kurrosetra/RCWS-mk3/Document/Wiring/Konektor Lists v.1.4.xlsx

Sheet: Connectors (1 RWS)
 | Series | Quantity | About | Manufacture
Plug | RE911-6-H-24-27-P | 1 | Slipring | Rotary Electronic
 | MS-3108-F-18-9-P | 1 | BMS | ITT
 | MS-3108-F-18-1-P | 2 | Ethernet | ITT
Receptacle | RE911-2-A-24-27-S | 1 | Slipring | Rotary Electronic
 | MS-3102-R-28-20-S | 2 | PDU & Adapter | ITT
 | MS-3102-R-24-7-S | 1 | Kokang | ITT
 | MS-3102-R-24-10-P | 1 | Baterry-PDU | ITT
 | MS-3102-R-20-27-S | 3 | Panel, Adapter & Kokang | ITT
 | MS-3102-R-18-9-S | 1 | BMS | ITT
 | MS-3102-R-18-1-S | 4 | Optronik dan Ethernet | ITT
 | MS-3102-R-16S-1-S | 2 | PDU & Panel | ITT
 | MS-3102-R-16-10-S | 2 | Trigger | ITT
 | MS-3102-R-14S-6-S | 3 | Programmer | ITT
Accessories | MS-25043-18D | 3 | Metal Caps (Ethernet & BMS) | ITT
 | MS-25043-14D | 3 | Metal Caps (Programmer) | ITT
 | 075-8520-000 | 2 | Sealing Gasket (PDU & Adapter) | ITT
 | 075-8519-000 | 2 | Sealing Gasket (Badu & Kokang) | ITT
 | 075-8517-000 | 3 | Sealing Gasket (Kokang, Panel, Adapter) | ITT
 | 075-8516-000 | 5 | Sealing Gasket (Optronik, Ethernet, BMS) | ITT
 | 075-8515-000 | 4 | Sealing Gasket (PDU, Panel, Trigger) | ITT
 | 075-8514-000 | 3 | Sealing Gasket (Programmer) | ITT
 | 012-0219-000 | 3 | Telescoping Bushing (Ethernet & BMS) | ITT
 |  | 52

Sheet: Cables (12 RWS)
Cables | Quantity
Cable#1st | 2 | pcs
Cable#2nd | 2 | pcs
Cable#3rd | 2 | pcs
Cable#4th | 2 | pcs
Cable#5th | - | pcs
Cable#6th | 12 | pcs
Cable#7th | 12 | pcs
Cable#8th | 12 | pcs
Cable#9th | 6 | pcs
