kurrosetra/RCWS-mk3/Document/fdcan_ID.xlsx

Sheet: FD-CAN params
device characteristics
FREQUENCY (kHz) | TOLERANCE (ppm) | NODE DELAY (ns) | PRESCALER | PRESCALER
 |  |  | NOMINAL | DATA
85 000 | 5 000 | 200 | 1 | 1 | Delete
Nominal bit calculations at base frequency
T q (ns) | Tprop_seg (ns) | Tbus_time (ns) | approx. cable length (m) | Prescaler: | Bit time: (Tq) | Tsync_seg (Tq) | Tprop_seg (Tq) | Tphase_seg1 (Tq) | Tphase_seg2 (Tq) | sjw (Tq) | sample point % | 2*df 1 (min) (ppm) | 2*df 2 (min) (ppm)
11.76470588 | 1470.588235 | 535.2941176 | 107.0588235 | 1 | 170 | 1 | 125 | 22 | 22 | 22 | - | 12941 | 10055
 |  |  |  |  |  |  |  |  |  |  | 87.06 +
Data bit calculations at base frequency
T q (ns) | Prescaler: | Bit time: (Tq) | Tsync_seg (Tq) | Tprop_seg (Tq) | Tphase_seg1 (Tq) | Tphase_seg2 (Tq) | sjw (Tq) | sample point: % | 2*df 3 (min) (ppm) | 2*df 4 (min) (ppm) | 2*df 5 (min) (ppm)
11.76470588 | 1 | 17 | 1 | 0 | 8 | 8 | 8 | - | 47059 | 17134 | 20305
 |  |  |  |  |  |  |  | 52.94 +
Individual Bus Timing Parameters
 | Nominal (500 000 bit/s) |  |  |  |  | Data (5 000 000 bit/s) |  |  |  |  | Tolerance (ppm)
FREQUENCY (kHz) | Tseg1 | Tseg2 | SJW | SP | PRESCALER | Tseg1 | Tseg2 | SJW | SP | PRESCALER | SYSTEM | df1 | df2 | df3 | df4 | df5
85 000 | 125 + 22 = 147 | 22 | 22 | 87.06% | 1 | 8 | 8 | 8 | 52.94% | 1 | 10 000 | 12941 | 10055 | 47059 | 17134 | 20305

Sheet: RWS-MK3
ID (Bit) |  |  |  |  |  |  |  |  |  |  | DLC | DATA (BYTE)
10 | 9 | 8 | 7 | 6 | 5 | 4 | 3 | 2 | 1 | 0 |  | 0 | 1 | 2 | 3 | 4 | 5 | 6 | 7 | 8 | 9 | 10 | 11 | 12 | 13 | 14 | 15 | 16 | 17 | 18 | 19 | 20 | 21 | 22 | 23 | 24 | 25 | 26 | 27 | 28 | 29 | 30 | 31 | 32 | 33 | 34 | 35 | 36 | 37 | 38 | 39 | 40 | 41 | 42 | 43 | 44 | 45 | 46 | 47
011 (RWS) |  |  | 0000: Motor |  |  |  | 0000: Motor & Weapon Status |  |  |  | C | Motor Status | Weapon Status |  |  | Motor Actual Value
 |  |  |  |  |  |  |  |  |  |  |  | bit0: PAN enable | bit0: Trigger Enable | Munition Counter (MSB first) |  | Actual Pan Position Value ( float in ⁰) |  |  |  | Actual Tilt Position Value (float in ⁰) |  |  |  | Actual Pan Speed Value ( float in ⁰/s) |  |  |  | Actual Tilt Speed Value ( float in ⁰/s) |  |  |  | Actual Pan voltage (V) |  | Actual Pan Current (0.1A) |  | Actual Tilt voltage (V) |  | Actual Tilt Current (0.1A) |  | RESV
 |  |  |  |  |  |  |  |  |  |  |  | bit1: TILT enable | bit1: Kokang Moving
 |  |  |  |  |  |  |  |  |  |  |  | bit2: Pan Zero Reached
 |  |  |  |  |  |  |  |  |  |  |  | bit3: Tilt Upward Reached
 |  |  |  |  |  |  |  |  |  |  |  | bit4: Tilt Downward Reached
 |  |  |  |  |  |  |  |  |  |  |  | bit5: PAN fault
 |  |  |  |  |  |  |  |  |  |  |  | bit6: TILT fault
 |  |  |  |  |  |  |  |  |  |  |  | bit7: resv
 |  |  |  |  |  |  | RESV |  |  |  | 0
 |  |  | 0001: PANEL |  |  |  | 0000: Panel & Button Command |  |  |  | B | Movement mode: | camera command: | Weapon command: | LRF & IMU command: | Motor Command
 |  |  |  |  |  |  |  |  |  |  |  | bit0: PAN enable | bit0: | bit0: Trigger Enable | bit0: LRF ENABLE | PAN Speed Desired (in ⁰/s) |  |  |  | TILT Speed Desired (in ⁰/s) |  |  |  | PAN Speed Correction (in ⁰/s) |  |  |  | TILT Speed Correction (in ⁰/s)
 |  |  |  |  |  |  |  |  |  |  |  | bit1: TILT enable | 0: day camera | bit1: Cock Start | bit1: LRF START
 |  |  |  |  |  |  |  |  |  |  |  | bit2: Stabilize Mode | 1: thermal camera | bit2: Munition Counter Reset | bit2: Continous mode
 |  |  |  |  |  |  |  |  |  |  |  | bit3: Track Mode | bit[2..1]: |  | bit3: LRF POINTER ON/OFF
 |  |  |  |  |  |  |  |  |  |  |  |  | 00: no zoom |  | bit4: IMU fast rate
 |  |  |  |  |  |  |  |  |  |  |  |  | 01: zoom in
 |  |  |  |  |  |  |  |  |  |  |  |  | 10: zoom out
 |  |  |  |  |  |  |  |  |  |  |  |  | bit[4..3]:
 |  |  |  |  |  |  |  |  |  |  |  |  | 00: no focus
 |  |  |  |  |  |  |  |  |  |  |  |  | 01: focus far
 |  |  |  |  |  |  |  |  |  |  |  |  | 10: focus near
 |  |  |  |  |  |  |  |  |  |  |  |  | bit[6..5]:
 |  |  |  |  |  |  |  |  |  |  |  |  | 00: none
 |  |  |  |  |  |  |  |  |  |  |  |  | 01: resv up
 |  |  |  |  |  |  |  |  |  |  |  |  | 10: resv down
 |  |  |  |  |  |  |  |  |  |  |  |  | bit7:
 |  |  |  |  |  |  |  |  |  |  |  |  | 0:stabilizer OFF
 |  |  |  |  |  |  |  |  |  |  |  |  | 1: stabilizer ON
 |  |  |  |  |  |  | RESV |  |  |  | 0
 |  |  | 0010: Optronik |  |  |  | 0000: Optronik Status |  |  |  | 8 | camera state: | LRF Value:
 |  |  |  |  |  |  |  |  |  |  |  | bit0: camera selection | Counter | Distance 1 (MSB first) |  | Distance 2 (MSB first) |  | Distance 3 (MSB first)
 |  |  |  |  |  |  |  |  |  |  |  | 0: SONY Active
 |  |  |  |  |  |  |  |  |  |  |  | 1: Thermal Active
 |  |  |  |  |  |  |  |  |  |  |  | bit[1..3]: zoom value
 |  |  |  |  |  |  | RESV
 |  |  | 0011: IMU |  |  |  | 0000: IMU Value |  |  |  | 9 | YAW |  |  |  | PITCH |  |  |  | ROLL
 |  |  |  |  |  |  |  |  |  |  |  | -180.000f s/d 180.000f |  |  |  | -90.000f s/d 90.000f |  |  |  | -90.000f s/d 90.000f
 |  |  |  |  |  |  | RESV |  |  |  | 0

Sheet: Update Rate
ID |  |  | Name | Update Rate (ms) | BUS LOAD (500kbps) | BUS LOAD (250kbps)
3 | 0 | 0 | Motor & Weapon Status | 50 | 2620 | 2620
 | 1 | 0 | Panel & Button Command | 50 | 2620 | 2620
 | 2 | 0 | Optronik Status | 100 | 1310 | 1310
 | 3 | 0 | IMU Value | 50 | 2620 | 2620
 |  |  |  | %= | 1.834 | 3.668

Sheet: PC
SEND to PC:
0 | 1 | 2 | 3 | 4 | 5 | 6
state | lrf value (m) |  | rws's az angle (deg) |  | rws's el angle (1/100 deg)
bit[0]: camera active (0: day camera, 1: thermal)
bit[1..2]: zoom level (0: observe view, 1: combat view, 2: tele view)
bit[3..4]: tracker target select (0: select stop, 1: next, 2: prev)
bit[5..6]: tracker gate resize (0: resize stop, 1: bigger, 2: smaller)
RECV from PC:
0 | 1 | 2 | 3 | 4 | 5 | 6 | 7 | 8 | 9 | 10 | 11
state | balistik offset (px)
bit[0]: weapon type (0: 7.62mm, 1: 12.7mm)
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
