kurrosetra/RCWS-mk3/Document/Wiring/Konektor Lists v.1.2a.xlsx

 | Series | Quantity | About
Plug | RE911-6-H-24-27-P | 1 | Slipring
 | MS-3108-F-18-9-P | 1 | BMS
 | MS-3108-F-18-1-P | 2 | Ethernet
 | MS-3106-F-14S-6-P | 1 | Programmer
Receptacle | RE911-2-A-24-27-S | 1 | Slipring
 | MS-3102-R-28-20-S | 2 | PDU & Adapter
 | MS-3102-R-24-7-S | 1 | Kokang
 | MS-3102-R-24-10-P | 1 | Baterry-PDU
 | MS-3102-R-20-27-S | 3 | Panel, Adapter & Kokang
 | MS-3102-R-18-9-S | 1 | BMS
 | MS-3102-R-18-1-S | 4 | Optronik dan Ethernet
 | MS-3102-R-16S-1-S | 2 | PDU & Panel
 | MS-3102-R-16-10-S | 2 | Trigger
 | MS-3102-R-14S-6-S | 3 | Programmer
Accessories | MS-25043-18D | 3 | Metal Caps (Ethernet & BMS)
 | MS-25043-14D | 3 | Metal Caps (Programmer)
 | 075-8520-000 | 2 | Sealing Gasket (PDU & Adapter)
 | 075-8519-000 | 2 | Sealing Gasket (Badu & Kokang)
 | 075-8517-000 | 3 | Sealing Gasket (Kokang, Panel, Adapter)
 | 075-8516-000 | 5 | Sealing Gasket (Optronik, Ethernet, BMS)
 | 075-8515-000 | 4 | Sealing Gasket (PDU, Panel, Trigger)
 | 075-8514-000 | 3 | Sealing Gasket (Programmer)
 | 012-8554-000 | 1 | Telescoping Bushing (Programmer)
 | 012-0219-000 | 3 | Telescoping Bushing (Ethernet & BMS)
 |  | 54
