kurrosetra/RCWS-mk3/Panel/Board/Panel.brd

## EAGLE design Panel/Board/Panel.brd (2022-07-08)

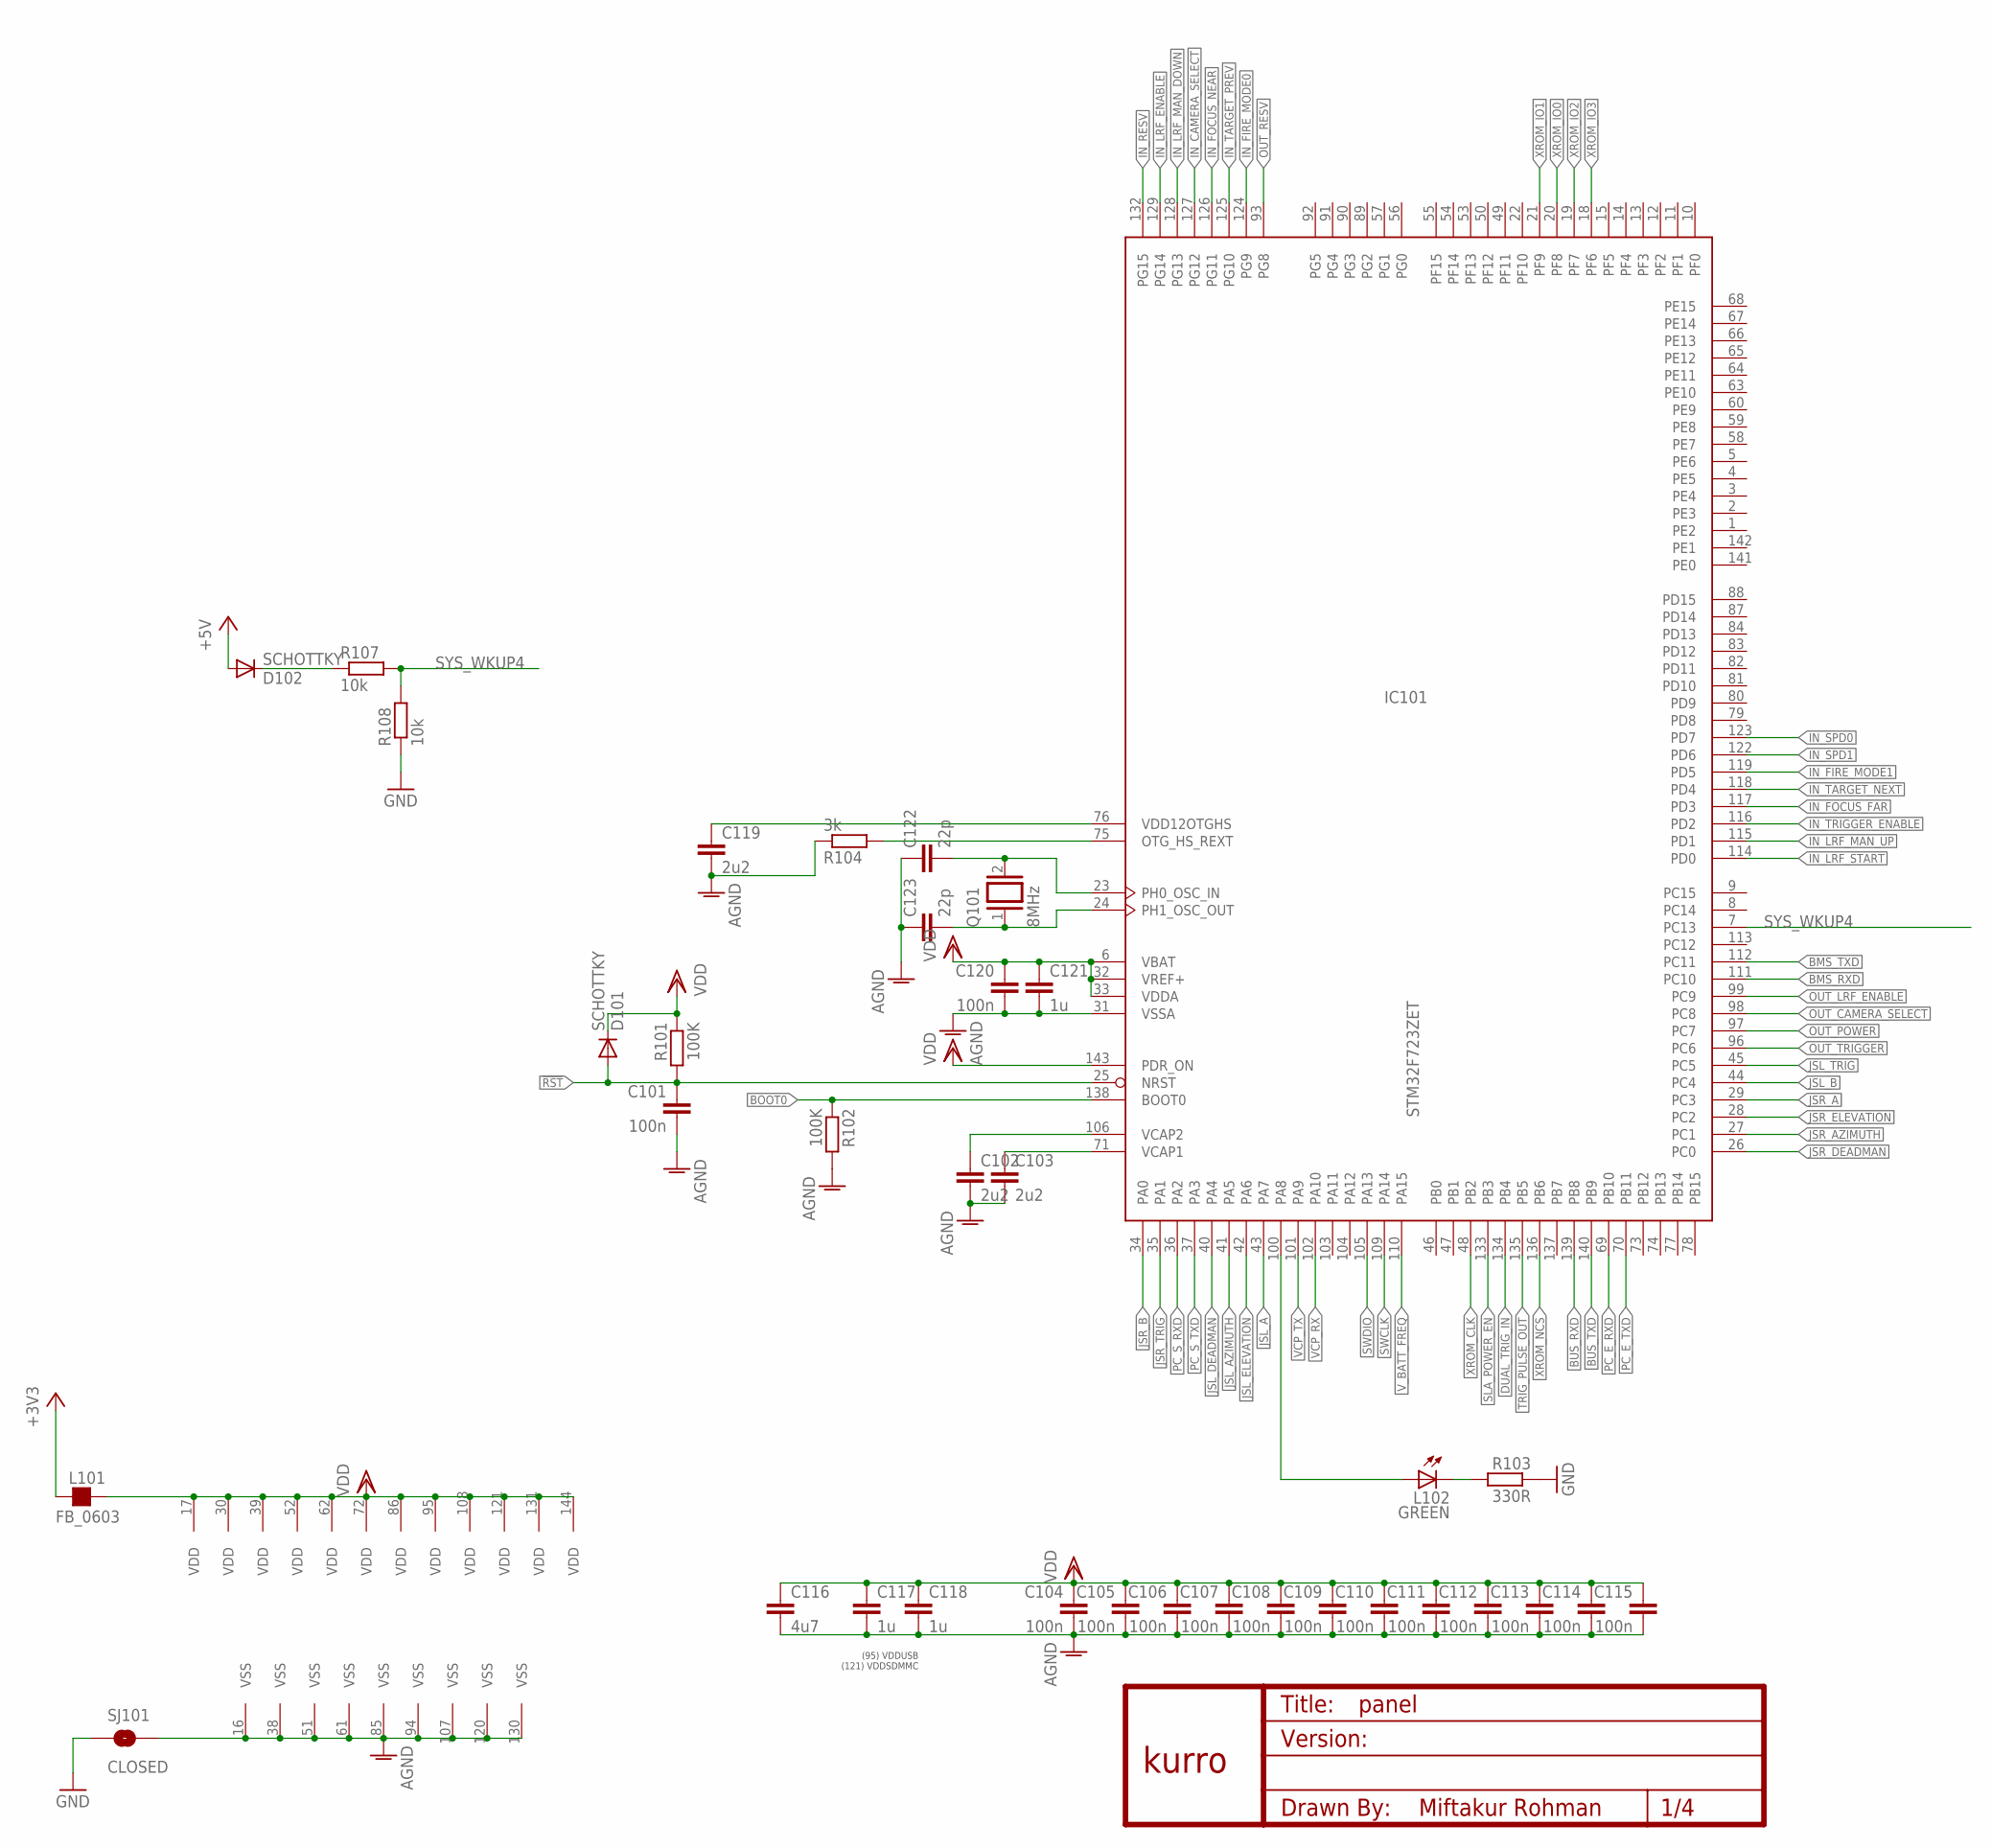
[picture p1: schematic Panel.sch, sheet 1, MAIN]

Parts:
C101, C104, C105, C106, C107, C108, C109, C110, C111, C112, C113, C114, C115, C120: 100n; C0603
C102, C103, C119: 2u2; C0805
C116: 4u7; C0805
C117, C118, C121: 1u; C0805
C122, C123: 22p; C0603
D101, D102: SCHOTTKY; MICROMELF-W
IC101: STM32F723ZET; LQFP144-2
L101: FB_0603; L0603
L102: GREEN; CHIP-LED0805
Q101: 8MHz; QS
R101, R102: 100K; R0603
R103: 330R; R0603
R104: 3k; R0603
R107, R108: 10k; R0603
SJ101: CLOSED; SJ_2S-TRACE_THICK
U$2: KURRO_FOOTPRINT; KURRO-LOGO

Connections:
!RST: C101.1, D101.A, IC101.25 (NRST), R101.2; also elsewhere on the board
+3V3: L101.1; also elsewhere on the board
+5V: D102.A; also elsewhere on the board
AGND: C101.2, C102.2, C103.2, C104.2, C105.2, C106.2, C107.2, C108.2, C109.2, C110.2, C111.2, C112.2, C113.2, C114.2, C115.2, C116.2, C117.2, C118.2, C119.2, C120.2, C121.2, C122.1, C123.1, IC101.16 (VSS), IC101.31 (VSSA), IC101.38 (VSS), IC101.51 (VSS), IC101.61 (VSS), IC101.85 (VSS), IC101.94 (VSS), IC101.107 (VSS), IC101.120 (VSS), IC101.130 (VSS), R102.2, R104.1, SJ101.2
BMS_RXD: IC101.111 (PC10); also elsewhere on the board
BMS_TXD: IC101.112 (PC11); also elsewhere on the board
BOOT0: IC101.138 (BOOT0), R102.1; also elsewhere on the board
BUS_RXD: IC101.139 (PB8); also elsewhere on the board
BUS_TXD: IC101.140 (PB9); also elsewhere on the board
DUAL_TRIG_IN: IC101.134 (PB4); also elsewhere on the board
GND: R103.1, R108.1, SJ101.1; also elsewhere on the board
IN_CAMERA_SELECT: IC101.127 (PG12); also elsewhere on the board
IN_FIRE_MODE0: IC101.124 (PG9); also elsewhere on the board
IN_FIRE_MODE1: IC101.119 (PD5); also elsewhere on the board
IN_FOCUS_FAR: IC101.117 (PD3); also elsewhere on the board
IN_FOCUS_NEAR: IC101.126 (PG11); also elsewhere on the board
IN_LRF_ENABLE: IC101.129 (PG14); also elsewhere on the board
IN_LRF_MAN_DOWN: IC101.128 (PG13); also elsewhere on the board
IN_LRF_MAN_UP: IC101.115 (PD1); also elsewhere on the board
IN_LRF_START: IC101.114 (PD0); also elsewhere on the board
IN_RESV: IC101.132 (PG15); also elsewhere on the board
IN_SPD0: IC101.123 (PD7); also elsewhere on the board
IN_SPD1: IC101.122 (PD6); also elsewhere on the board
IN_TARGET_NEXT: IC101.118 (PD4); also elsewhere on the board
IN_TARGET_PREV: IC101.125 (PG10); also elsewhere on the board
IN_TRIGGER_ENABLE: IC101.116 (PD2); also elsewhere on the board
JSL_A: IC101.43 (PA7); also elsewhere on the board
JSL_AZIMUTH: IC101.41 (PA5); also elsewhere on the board
JSL_B: IC101.44 (PC4); also elsewhere on the board
JSL_DEADMAN: IC101.40 (PA4); also elsewhere on the board
JSL_ELEVATION: IC101.42 (PA6); also elsewhere on the board
JSL_TRIG: IC101.45 (PC5); also elsewhere on the board
JSR_A: IC101.29 (PC3); also elsewhere on the board
JSR_AZIMUTH: IC101.27 (PC1); also elsewhere on the board
JSR_B: IC101.34 (PA0); also elsewhere on the board
JSR_DEADMAN: IC101.26 (PC0); also elsewhere on the board
JSR_ELEVATION: IC101.28 (PC2); also elsewhere on the board
JSR_TRIG: IC101.35 (PA1); also elsewhere on the board
unnamed: IC101.75 (OTG_HS_REXT), R104.2
unnamed: L102.C, R103.2
unnamed: IC101.100 (PA8), L102.A
unnamed: C119.1, IC101.76 (VDD12OTGHS)
unnamed: C123.2, IC101.24 (PH1_OSC_OUT), Q101.1
unnamed: C122.2, IC101.23 (PH0_OSC_IN), Q101.2
unnamed: D102.C, R107.1
OUT_CAMERA_SELECT: IC101.98 (PC8); also elsewhere on the board
OUT_LRF_ENABLE: IC101.99 (PC9); also elsewhere on the board
OUT_POWER: IC101.97 (PC7); also elsewhere on the board
OUT_RESV: IC101.93 (PG8); also elsewhere on the board
OUT_TRIGGER: IC101.96 (PC6); also elsewhere on the board
PC_E_RXD: IC101.69 (PB10); also elsewhere on the board
PC_E_TXD: IC101.70 (PB11); also elsewhere on the board
PC_S_RXD: IC101.36 (PA2); also elsewhere on the board
PC_S_TXD: IC101.37 (PA3); also elsewhere on the board
SLA_POWER_EN: IC101.133 (PB3); also elsewhere on the board
SWCLK: IC101.109 (PA14); also elsewhere on the board
SWDIO: IC101.105 (PA13); also elsewhere on the board
SYS_WKUP4: IC101.7 (PC13), R107.2, R108.2
TRIG_PULSE_OUT: IC101.135 (PB5); also elsewhere on the board
VCAP1: C103.1, IC101.71 (VCAP1)
VCAP2: C102.1, IC101.106 (VCAP2)
VCP_RX: IC101.102 (PA10); also elsewhere on the board
VCP_TX: IC101.101 (PA9); also elsewhere on the board
VDD: C104.1, C105.1, C106.1, C107.1, C108.1, C109.1, C110.1, C111.1, C112.1, C113.1, C114.1, C115.1, C116.1, C117.1, C118.1, C120.1, C121.1, D101.C, IC101.6 (VBAT), IC101.17 (VDD), IC101.30 (VDD), IC101.32 (VREF+), IC101.33 (VDDA), IC101.39 (VDD), IC101.52 (VDD), IC101.62 (VDD), IC101.72 (VDD), IC101.86 (VDD), IC101.95 (VDD), IC101.108 (VDD), IC101.121 (VDD), IC101.131 (VDD), IC101.143 (PDR_ON), IC101.144 (VDD), L101.2, R101.1; also elsewhere on the board
V_BATT_FREQ: IC101.110 (PA15); also elsewhere on the board
XROM_CLK: IC101.48 (PB2); also elsewhere on the board
XROM_IO0: IC101.20 (PF8); also elsewhere on the board
XROM_IO1: IC101.21 (PF9); also elsewhere on the board
XROM_IO2: IC101.19 (PF7); also elsewhere on the board
XROM_IO3: IC101.18 (PF6); also elsewhere on the board
XROM_NCS: IC101.136 (PB6); also elsewhere on the board

Notes on the sheet:
(95) VDDUSB (121) VDDSDMMC

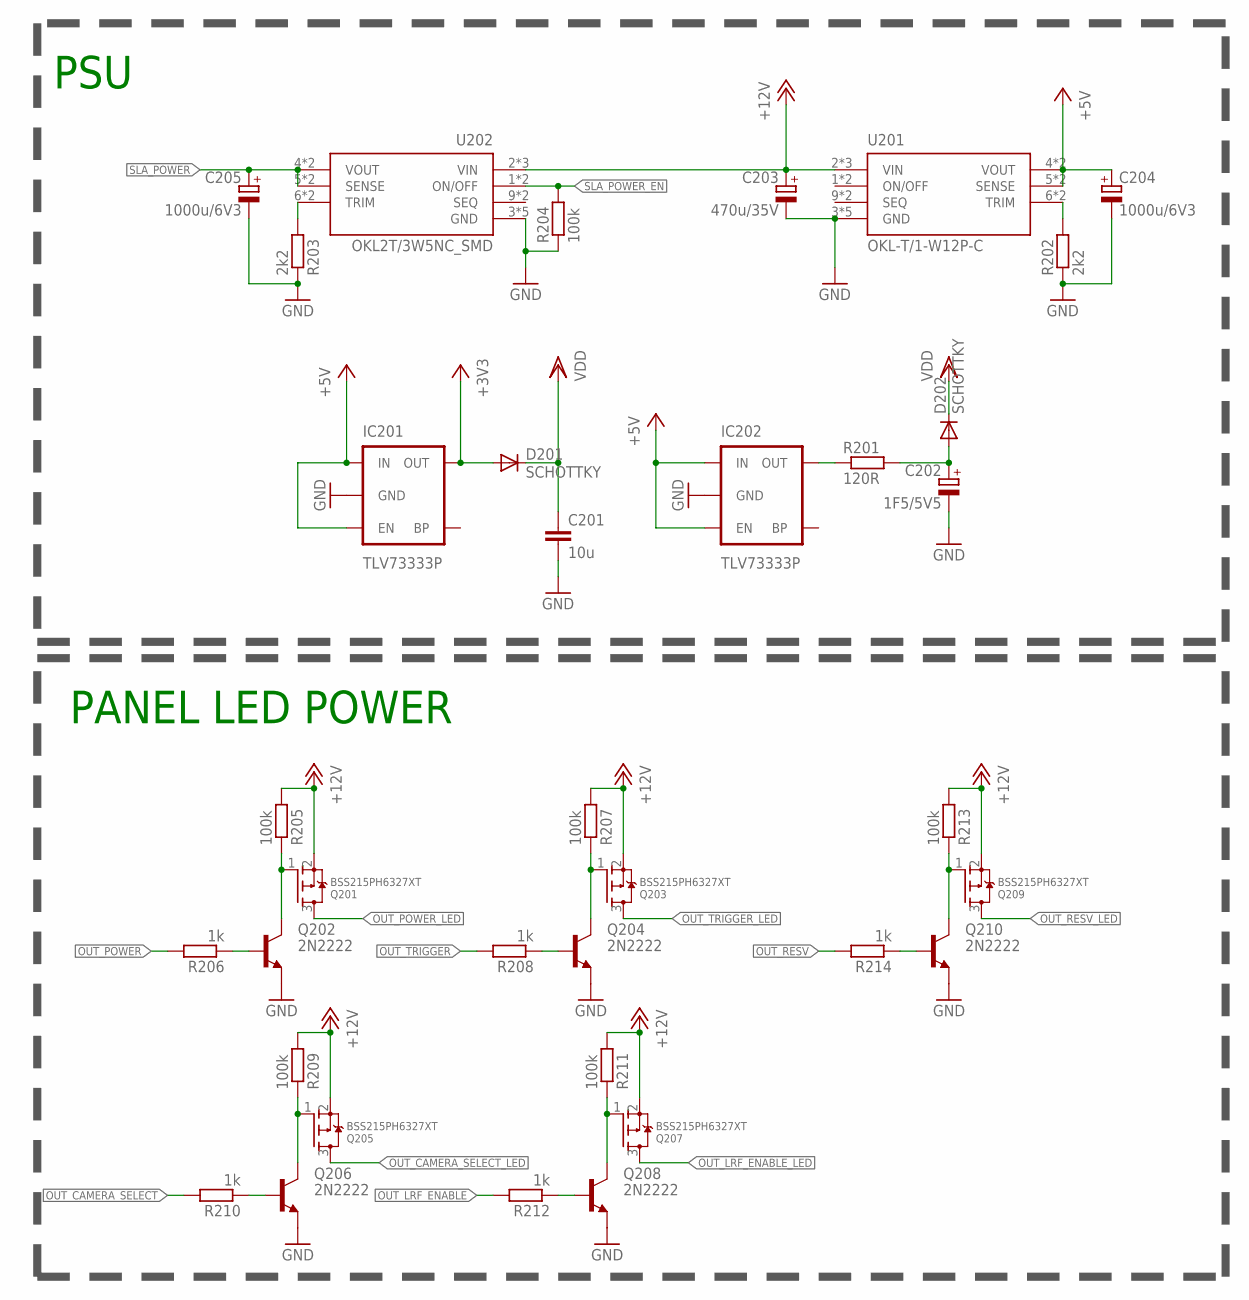
[picture p2: schematic Panel.sch, sheet 2, PSU]

Parts:
C201: 10u; C0805
C202: 1F5/5V5; SC_1F/5V5
C203: 470u/35V; 153CLV-1012
C204, C205: 1000u/6V3; 153CLV-0810
D201, D202: SCHOTTKY; MICROMELF-W
IC201, IC202: TLV73333P; SOT23-5
Q201, Q203, Q205, Q207, Q209: BSS215PH6327XT; SOT23-W
Q202, Q204, Q206, Q208, Q210: 2N2222; SOT23
R201: 120R; R0603
R202, R203: 2k2; R0603
R204, R205, R207, R209, R211, R213: 100k; R0603
R206, R208, R210, R212, R214: 1k; R0603
U201: OKL-T/1-W12P-C; OKL2T/3W5NC
U202: OKL2T/3W5NC_SMD; OKL2T/3W5NC

Connections:
+3V3: D201.A, IC201.5 (OUT); also elsewhere on the board
+5V: C204.+, IC201.1 (IN), IC201.3 (EN), IC202.1 (IN), IC202.3 (EN), U201.4 (VOUT), U201.4@1 (VOUT), U201.5 (SENSE), U201.5@1 (SENSE); also elsewhere on the board
+12V: C203.+, Q201.2 (S), Q203.2 (S), Q205.2 (S), Q207.2 (S), Q209.2 (S), R205.2, R207.2, R209.2, R211.2, R213.2, U201.2 (VIN), U201.2@1 (VIN), U201.2@2 (VIN), U202.2 (VIN), U202.2@1 (VIN), U202.2@2 (VIN); also elsewhere on the board
GND: C201.2, C202.2 (-), C203.-, C204.-, C205.-, IC201.2 (GND), IC202.2 (GND), Q202.2 (E), Q204.2 (E), Q206.2 (E), Q208.2 (E), Q210.2 (E), R202.1, R203.1, R204.1, U201.3 (GND), U201.3@1 (GND), U201.3@2 (GND), U201.7 (GND), U201.7@1 (GND), U202.3 (GND), U202.3@1 (GND), U202.3@2 (GND), U202.7 (GND), U202.7@1 (GND); also elsewhere on the board
unnamed: R202.2, U201.6 (TRIM), U201.6@1 (TRIM)
unnamed: IC202.5 (OUT), R201.1
unnamed: Q209.1 (G), Q210.3 (C), R213.1
unnamed: Q201.1 (G), Q202.3 (C), R205.1
unnamed: Q202.1 (B), R206.1
unnamed: Q203.1 (G), Q204.3 (C), R207.1
unnamed: Q204.1 (B), R208.1
unnamed: Q210.1 (B), R214.1
unnamed: Q205.1 (G), Q206.3 (C), R209.1
unnamed: Q206.1 (B), R210.1
unnamed: Q207.1 (G), Q208.3 (C), R211.1
unnamed: Q208.1 (B), R212.1
unnamed: R203.2, U202.6 (TRIM), U202.6@1 (TRIM)
OUT_CAMERA_SELECT: R210.2; also elsewhere on the board
OUT_CAMERA_SELECT_LED: Q205.3 (D); also elsewhere on the board
OUT_LRF_ENABLE: R212.2; also elsewhere on the board
OUT_LRF_ENABLE_LED: Q207.3 (D); also elsewhere on the board
OUT_POWER: R206.2; also elsewhere on the board
OUT_POWER_LED: Q201.3 (D); also elsewhere on the board
OUT_RESV: R214.2; also elsewhere on the board
OUT_RESV_LED: Q209.3 (D); also elsewhere on the board
OUT_TRIGGER: R208.2; also elsewhere on the board
OUT_TRIGGER_LED: Q203.3 (D); also elsewhere on the board
SLA_POWER: C205.+, U202.4 (VOUT), U202.4@1 (VOUT), U202.5 (SENSE), U202.5@1 (SENSE); also elsewhere on the board
SLA_POWER_EN: R204.2, U202.1 (ON/OFF), U202.1@1 (ON/OFF); also elsewhere on the board
VDD: C201.1, D201.C, D202.C; also elsewhere on the board
V_SCAP1: C202.1 (+), D202.A, R201.2

Notes on the sheet:
PSU
PANEL LED POWER

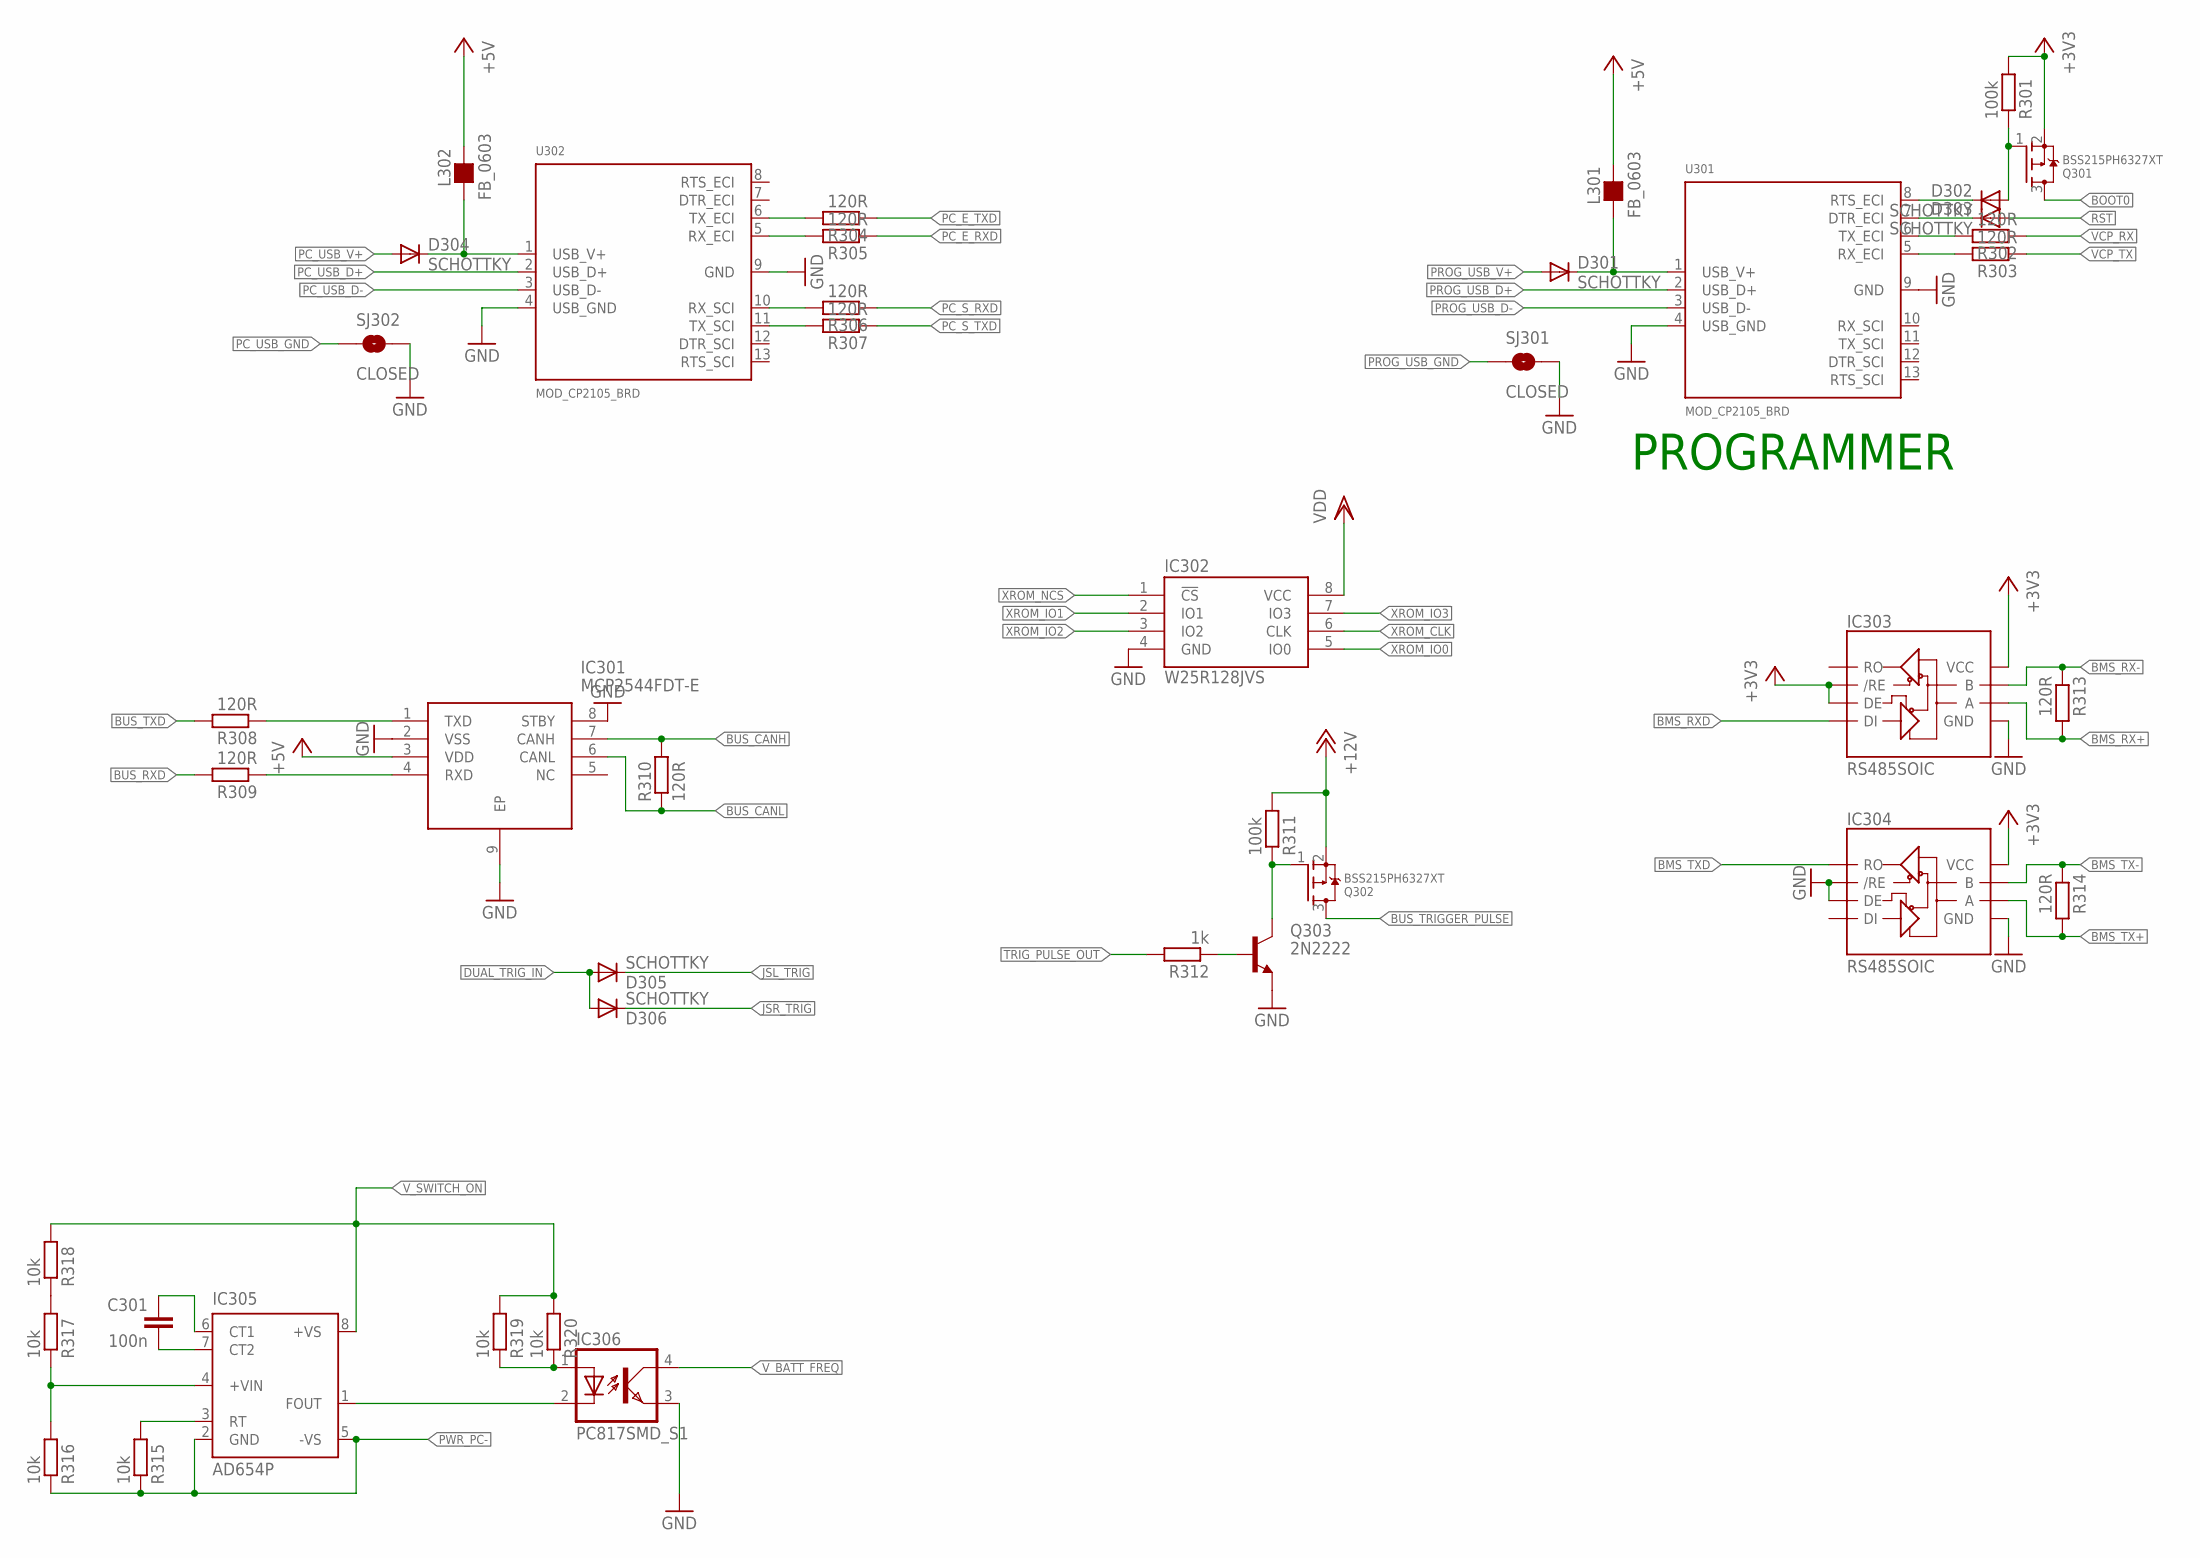
[picture p3: schematic Panel.sch, sheet 3, I/F]

Parts:
C301: 100n; C0603
D301, D302, D303, D304, D305, D306: SCHOTTKY; MICROMELF-W
IC301: MCP2544FDT-E; TDFN-8
IC302: W25R128JVS; SO08
IC303, IC304: RS485SOIC; SO08
IC305: AD654P; DIL08
IC306: PC817SMD_S1; PC817SMD
L301, L302: FB_0603; L0603
Q301, Q302: BSS215PH6327XT; SOT23-W
Q303: 2N2222; SOT23
R301, R311: 100k; R0603
R302, R303, R304, R305, R306, R307, R308, R309, R310, R313, R314: 120R; R0603
R312: 1k; R0603
R315, R316, R317, R318, R319, R320: 10k; R0603
SJ301, SJ302: CLOSED; SJ_2S-TRACE_THICK
U301, U302: MOD_CP2105_BRD; MOD_CP2105_BOARD

Connections:
!RST: D303.A; also elsewhere on the board
+3V3: IC303.2 (/RE), IC303.3 (DE), IC303.8 (VCC), IC304.8 (VCC), Q301.2 (S), R301.2; also elsewhere on the board
+5V: IC301.3 (VDD), L301.2, L302.2; also elsewhere on the board
+12V: Q302.2 (S), R311.2; also elsewhere on the board
BMS_RX+: IC303.6 (A), R313.2; also elsewhere on the board
BMS_RX-: IC303.7 (B), R313.1; also elsewhere on the board
BMS_RXD: IC303.4 (DI); also elsewhere on the board
BMS_TX+: IC304.6 (A), R314.2; also elsewhere on the board
BMS_TX-: IC304.7 (B), R314.1; also elsewhere on the board
BMS_TXD: IC304.1 (RO); also elsewhere on the board
BOOT0: Q301.3 (D); also elsewhere on the board
BUS_CANH: IC301.7 (CANH), R310.2; also elsewhere on the board
BUS_CANL: IC301.6 (CANL), R310.1; also elsewhere on the board
BUS_RXD: R309.2; also elsewhere on the board
BUS_TRIGGER_PULSE: Q302.3 (D); also elsewhere on the board
BUS_TXD: R308.2; also elsewhere on the board
DUAL_TRIG_IN: D305.A, D306.A; also elsewhere on the board
GND: IC301.2 (VSS), IC301.8 (STBY), IC301.9 (EP), IC302.4 (GND), IC303.5 (GND), IC304.2 (/RE), IC304.3 (DE), IC304.5 (GND), IC306.3 (EMIT), Q303.2 (E), SJ301.2, SJ302.2, U301.4 (USB_GND), U301.9 (GND), U302.4 (USB_GND), U302.9 (GND); also elsewhere on the board
JSL_TRIG: D305.C; also elsewhere on the board
JSR_TRIG: D306.C; also elsewhere on the board
unnamed: Q302.1 (G), Q303.3 (C), R311.1
unnamed: Q303.1 (B), R312.1
unnamed: IC301.1 (TXD), R308.1
unnamed: IC301.4 (RXD), R309.1
unnamed: R303.2, U301.5 (RX_ECI)
unnamed: IC305.1 (FOUT), IC306.2 (C)
unnamed: R302.2, U301.6 (TX_ECI)
unnamed: D303.C, U301.7 (DTR_ECI)
unnamed: D302.C, U301.8 (RTS_ECI)
unnamed: D301.C, L301.1, U301.1 (USB_V+)
unnamed: D302.A, Q301.1 (G), R301.1
unnamed: R305.2, U302.5 (RX_ECI)
unnamed: R304.2, U302.6 (TX_ECI)
unnamed: R306.2, U302.10 (RX_SCI)
unnamed: R307.2, U302.11 (TX_SCI)
unnamed: IC306.1 (A), R319.1, R320.1
unnamed: D304.C, L302.1, U302.1 (USB_V+)
unnamed: IC305.3 (RT), R315.2
unnamed: C301.2, IC305.7 (CT2)
unnamed: C301.1, IC305.6 (CT1)
unnamed: IC305.4 (+VIN), R316.2, R317.1
unnamed: R317.2, R318.1
PC_E_RXD: R305.1; also elsewhere on the board
PC_E_TXD: R304.1; also elsewhere on the board
PC_S_RXD: R306.1; also elsewhere on the board
PC_S_TXD: R307.1; also elsewhere on the board
PC_USB_D+: U302.2 (USB_D+); also elsewhere on the board
PC_USB_D-: U302.3 (USB_D-); also elsewhere on the board
PC_USB_GND: SJ302.1; also elsewhere on the board
PC_USB_V+: D304.A; also elsewhere on the board
PROG_USB_D+: U301.2 (USB_D+); also elsewhere on the board
PROG_USB_D-: U301.3 (USB_D-); also elsewhere on the board
PROG_USB_GND: SJ301.1; also elsewhere on the board
PROG_USB_V+: D301.A; also elsewhere on the board
PWR_PC-: IC305.2 (GND), IC305.5 (-VS), R315.1, R316.1; also elsewhere on the board
TRIG_PULSE_OUT: R312.2; also elsewhere on the board
VCP_RX: R302.1; also elsewhere on the board
VCP_TX: R303.1; also elsewhere on the board
VDD: IC302.8 (VCC); also elsewhere on the board
V_BATT_FREQ: IC306.4 (COL); also elsewhere on the board
V_SWITCH_ON: IC305.8 (+VS), R318.2, R319.2, R320.2; also elsewhere on the board
XROM_CLK: IC302.6 (CLK); also elsewhere on the board
XROM_IO0: IC302.5 (IO0); also elsewhere on the board
XROM_IO1: IC302.2 (IO1); also elsewhere on the board
XROM_IO2: IC302.3 (IO2); also elsewhere on the board
XROM_IO3: IC302.7 (IO3); also elsewhere on the board
XROM_NCS: IC302.1 (!CS); also elsewhere on the board

Notes on the sheet:
PROGRAMMER

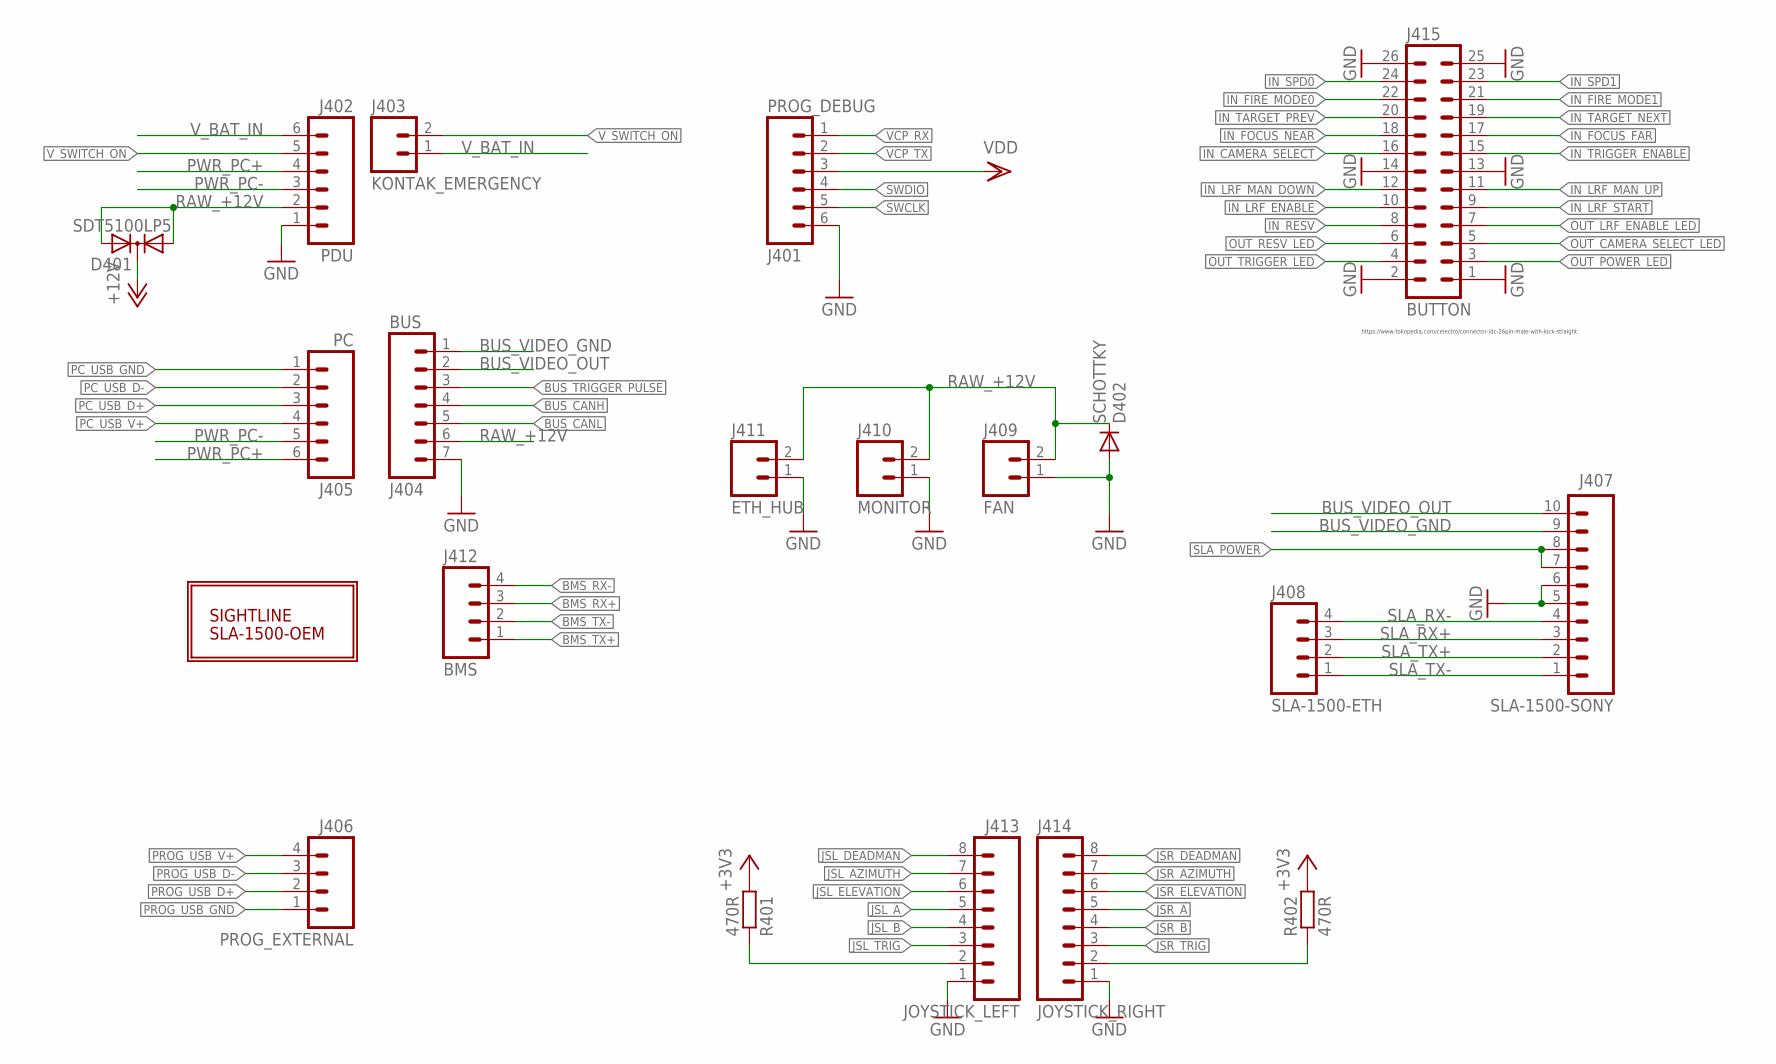
[picture p4: schematic Panel.sch, sheet 4, CONNECTOR]

Parts:
D401: SDT5100LP5; POWERDI5-3
D402: SCHOTTKY; MICROMELF-W
J401: PROG_DEBUG; XHS-6-VERT-SMD
J402: PDU; XHS-6-RA
J403: KONTAK_EMERGENCY; XHS-2-RA
J404: BUS; XHS-7-RA
J405: PC; XHS-6-RA
J406: PROG_EXTERNAL; XHS-4-RA
J407: SLA-1500-SONY; XHS-10-VERT
J408: SLA-1500-ETH; XHS-4-RA
J409: FAN; XHS-2-VERT
J410: MONITOR; XHS-2-RA
J411: ETH_HUB; XHS-2-VERT
J412: BMS; XHS-4-RA
J413: JOYSTICK_LEFT; XHS-8-RA
J414: JOYSTICK_RIGHT; XHS-8-RA
J415: BUTTON; 26V
R401, R402: 470R; R0603
U401: SLA-1500-OEM
U402: SLA-1500-OEM-RESTRICT; SLA_1500-OEM-RESTRICT

Connections:
+3V3: R401.2, R402.2; also elsewhere on the board
+12V: D401.3; also elsewhere on the board
BMS_RX+: J412.3; also elsewhere on the board
BMS_RX-: J412.4; also elsewhere on the board
BMS_TX+: J412.1; also elsewhere on the board
BMS_TX-: J412.2; also elsewhere on the board
BUS_CANH: J404.4; also elsewhere on the board
BUS_CANL: J404.5; also elsewhere on the board
BUS_TRIGGER_PULSE: J404.3; also elsewhere on the board
BUS_VIDEO_GND: J404.1, J407.9
BUS_VIDEO_OUT: J404.2, J407.10
GND: D402.A, J401.6, J402.1, J404.7, J407.5, J407.6, J409.1, J410.1, J411.1, J413.1, J414.1, J415.1, J415.2, J415.13, J415.14, J415.25, J415.26; also elsewhere on the board
IN_CAMERA_SELECT: J415.16; also elsewhere on the board
IN_FIRE_MODE0: J415.22; also elsewhere on the board
IN_FIRE_MODE1: J415.21; also elsewhere on the board
IN_FOCUS_FAR: J415.17; also elsewhere on the board
IN_FOCUS_NEAR: J415.18; also elsewhere on the board
IN_LRF_ENABLE: J415.10; also elsewhere on the board
IN_LRF_MAN_DOWN: J415.12; also elsewhere on the board
IN_LRF_MAN_UP: J415.11; also elsewhere on the board
IN_LRF_START: J415.9; also elsewhere on the board
IN_RESV: J415.8; also elsewhere on the board
IN_SPD0: J415.24; also elsewhere on the board
IN_SPD1: J415.23; also elsewhere on the board
IN_TARGET_NEXT: J415.19; also elsewhere on the board
IN_TARGET_PREV: J415.20; also elsewhere on the board
IN_TRIGGER_ENABLE: J415.15; also elsewhere on the board
JSL_A: J413.5; also elsewhere on the board
JSL_AZIMUTH: J413.7; also elsewhere on the board
JSL_B: J413.4; also elsewhere on the board
JSL_DEADMAN: J413.8; also elsewhere on the board
JSL_ELEVATION: J413.6; also elsewhere on the board
JSL_TRIG: J413.3; also elsewhere on the board
JSR_A: J414.5; also elsewhere on the board
JSR_AZIMUTH: J414.7; also elsewhere on the board
JSR_B: J414.4; also elsewhere on the board
JSR_DEADMAN: J414.8; also elsewhere on the board
JSR_ELEVATION: J414.6; also elsewhere on the board
JSR_TRIG: J414.3; also elsewhere on the board
unnamed: J414.2, R402.1
unnamed: J413.2, R401.1
OUT_CAMERA_SELECT_LED: J415.5; also elsewhere on the board
OUT_LRF_ENABLE_LED: J415.7; also elsewhere on the board
OUT_POWER_LED: J415.3; also elsewhere on the board
OUT_RESV_LED: J415.6; also elsewhere on the board
OUT_TRIGGER_LED: J415.4; also elsewhere on the board
PC_USB_D+: J405.3; also elsewhere on the board
PC_USB_D-: J405.2; also elsewhere on the board
PC_USB_GND: J405.1; also elsewhere on the board
PC_USB_V+: J405.4; also elsewhere on the board
PROG_USB_D+: J406.2; also elsewhere on the board
PROG_USB_D-: J406.3; also elsewhere on the board
PROG_USB_GND: J406.1; also elsewhere on the board
PROG_USB_V+: J406.4; also elsewhere on the board
PWR_PC+: J402.4, J405.6
PWR_PC-: J402.3, J405.5; also elsewhere on the board
RAW_+12V: D401.1, D401.2, D402.C, J402.2, J404.6, J409.2, J410.2, J411.2
SLA_POWER: J407.7, J407.8; also elsewhere on the board
SLA_RX+: J407.3, J408.3
SLA_RX-: J407.4, J408.4
SLA_TX+: J407.2, J408.2
SLA_TX-: J407.1, J408.1
SWCLK: J401.5; also elsewhere on the board
SWDIO: J401.4; also elsewhere on the board
VCP_RX: J401.1; also elsewhere on the board
VCP_TX: J401.2; also elsewhere on the board
VDD: J401.3; also elsewhere on the board
V_BAT_IN: J402.6, J403.1
V_SWITCH_ON: J402.5, J403.2; also elsewhere on the board

Notes on the sheet:
https://www.tokopedia.com/celectro/connector-idc-26pin-male-with-lock-straight

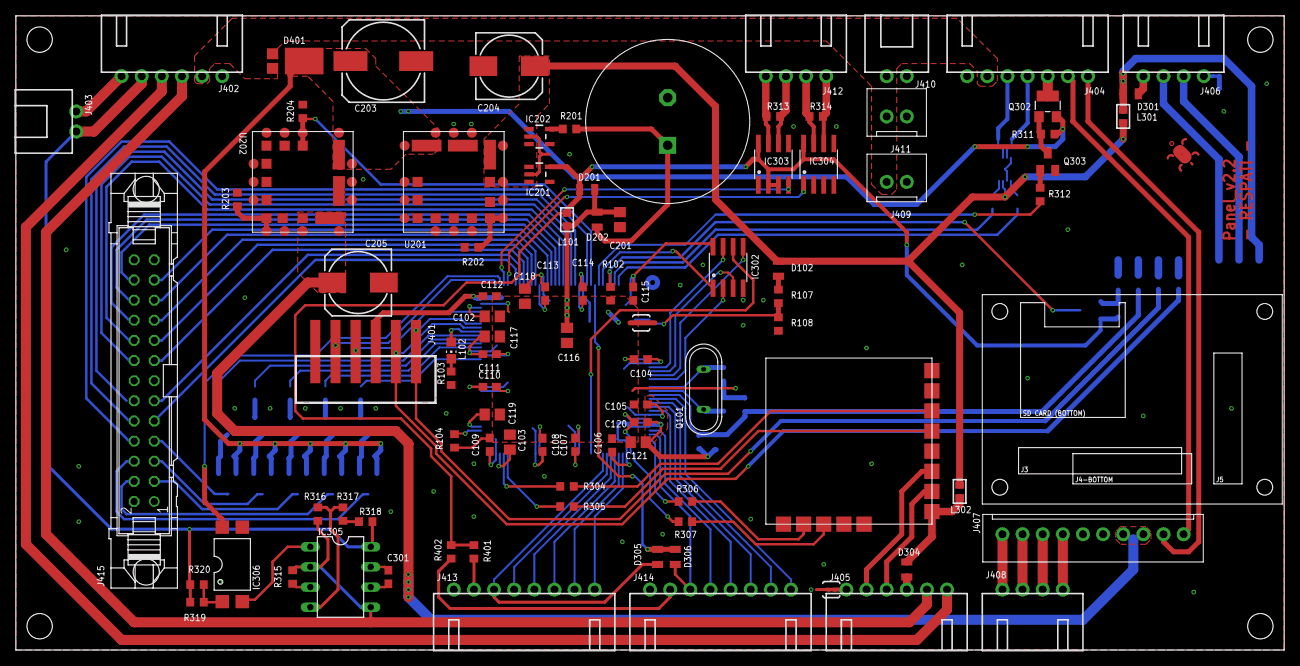
[picture p5: board Panel.brd from above]

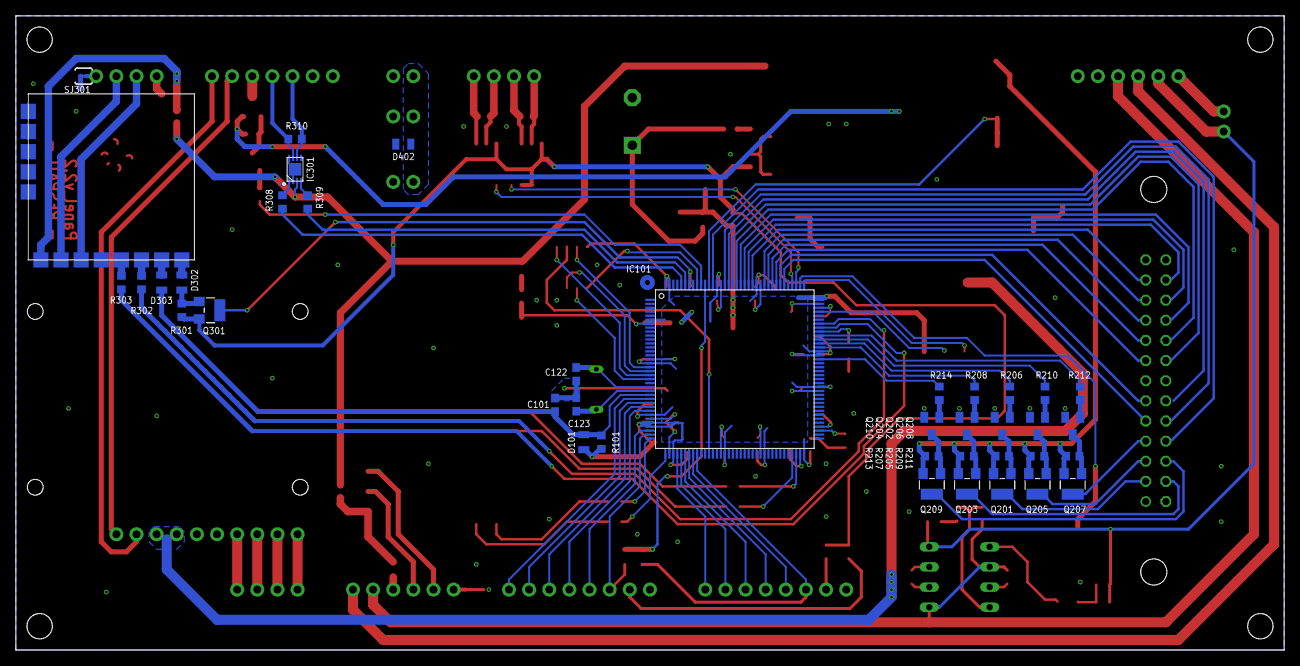
[picture p6: board Panel.brd from below]

Board: 2 copper layers, 160.0 x 80.0 mm, 135 parts (40 on the bottom side), 142 nets.
