kurrosetra/RCWS-mk3/MotorController/Board/MotorControl.brd

## EAGLE design MotorController/Board/MotorControl.brd (2022-07-08)

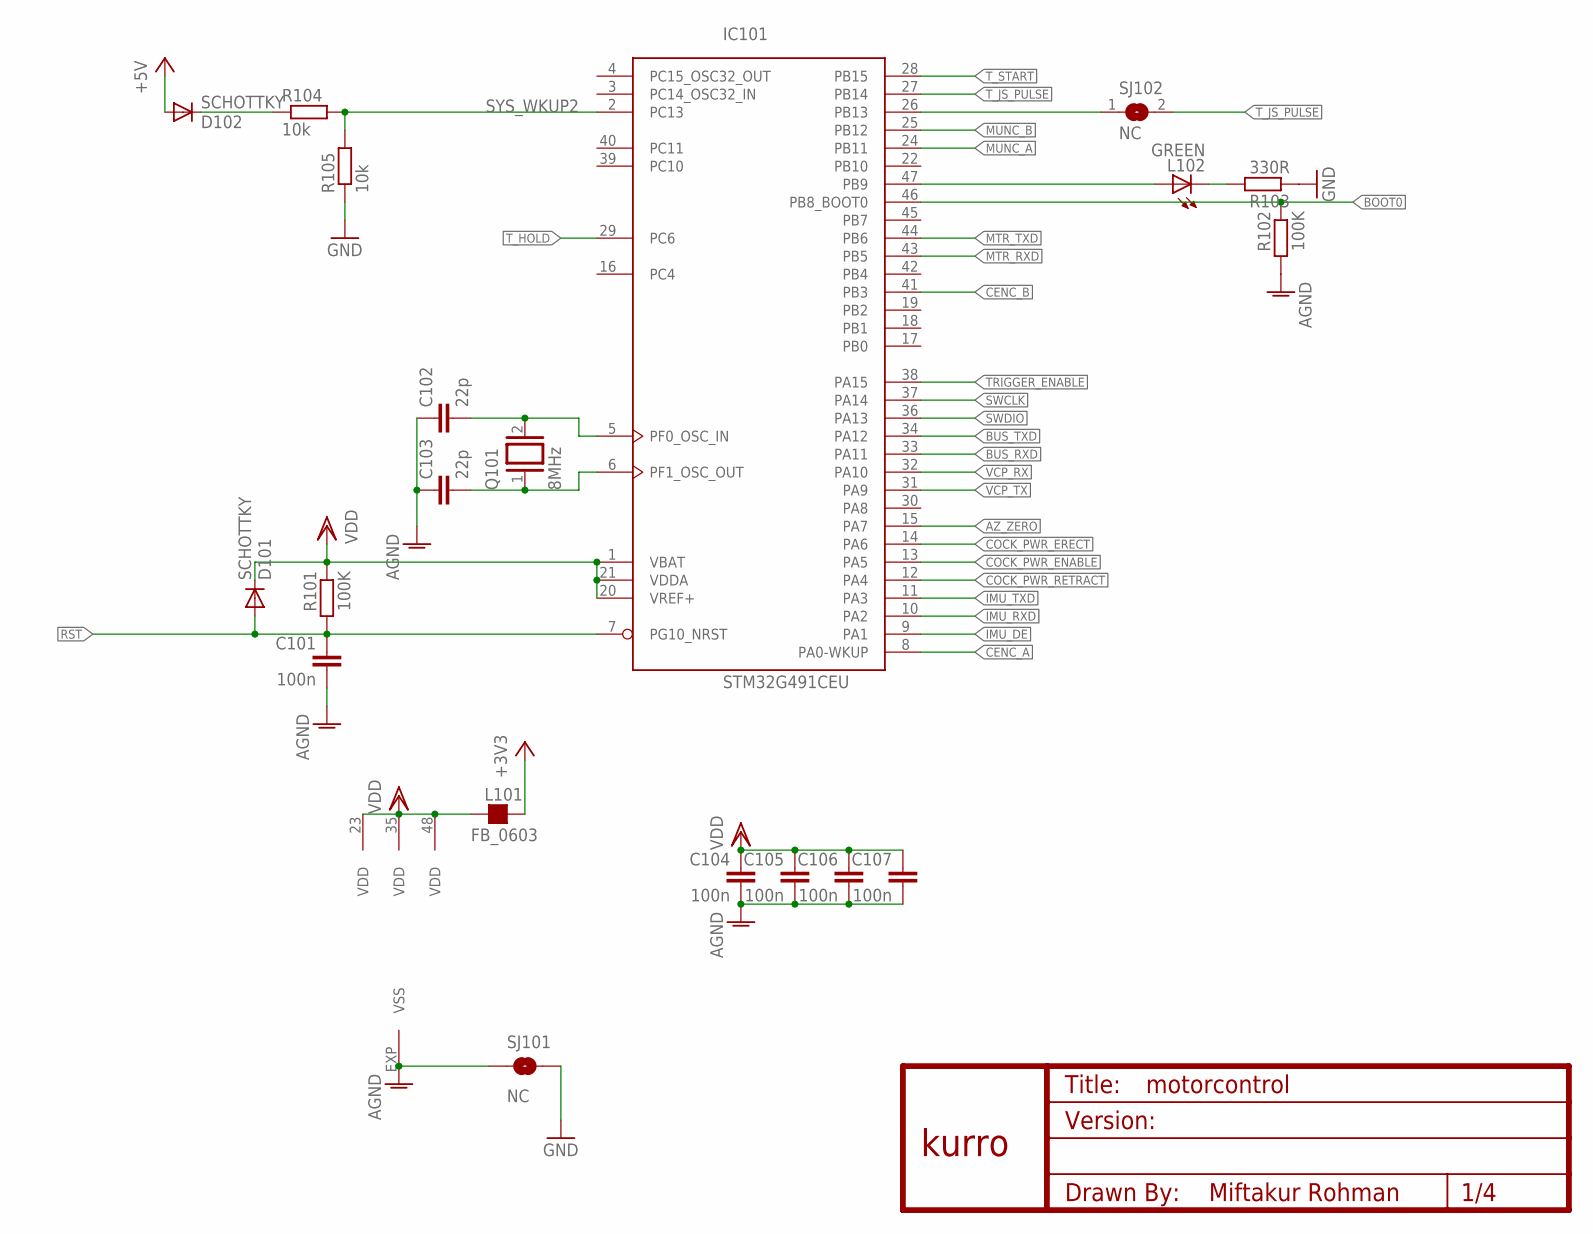
[picture p7: schematic MotorControl.sch, sheet 1]

Parts:
C101, C104, C105, C106, C107: 100n; C0603
C102, C103: 22p; C0603
D101, D102: SCHOTTKY; MICROMELF-W
IC101: STM32G491CEU; UFQFPN48
L101: FB_0603; L0603
L102: GREEN; CHIP-LED0805
Q101: 8MHz; QS
R101, R102: 100K; R0603
R103: 330R; R0603
R104, R105: 10k; R0603
SJ101: NC; SJ_2S-TRACE_THICK
SJ102: NC; SJS
U$1: KURRO_FOOTPRINT; KURRO-LOGO

Connections:
!RST: C101.1, D101.A, IC101.7 (PG10_NRST), R101.2; also elsewhere on the board
+3V3: L101.2; also elsewhere on the board
+5V: D102.A; also elsewhere on the board
AGND: C101.2, C102.1, C103.1, C104.2, C105.2, C106.2, C107.2, IC101.EXP (VSS), R102.2, SJ101.1
AZ_ZERO: IC101.15 (PA7); also elsewhere on the board
BOOT0: IC101.46 (PB8_BOOT0), R102.1; also elsewhere on the board
BUS_RXD: IC101.33 (PA11); also elsewhere on the board
BUS_TXD: IC101.34 (PA12); also elsewhere on the board
CENC_A: IC101.8 (PA0-WKUP); also elsewhere on the board
CENC_B: IC101.41 (PB3); also elsewhere on the board
COCK_PWR_ENABLE: IC101.13 (PA5); also elsewhere on the board
COCK_PWR_ERECT: IC101.14 (PA6); also elsewhere on the board
COCK_PWR_RETRACT: IC101.12 (PA4); also elsewhere on the board
GND: R103.1, R105.1, SJ101.2; also elsewhere on the board
IMU_DE: IC101.9 (PA1); also elsewhere on the board
IMU_RXD: IC101.10 (PA2); also elsewhere on the board
IMU_TXD: IC101.11 (PA3); also elsewhere on the board
MTR_RXD: IC101.43 (PB5); also elsewhere on the board
MTR_TXD: IC101.44 (PB6); also elsewhere on the board
MUNC_A: IC101.24 (PB11); also elsewhere on the board
MUNC_B: IC101.25 (PB12); also elsewhere on the board
unnamed: IC101.47 (PB9), L102.A
unnamed: L102.C, R103.2
unnamed: D102.C, R104.1
unnamed: C103.2, IC101.6 (PF1_OSC_OUT), Q101.1
unnamed: IC101.26 (PB13), SJ102.1
unnamed: C102.2, IC101.5 (PF0_OSC_IN), Q101.2
SWCLK: IC101.37 (PA14); also elsewhere on the board
SWDIO: IC101.36 (PA13); also elsewhere on the board
SYS_WKUP2: IC101.2 (PC13), R104.2, R105.2
TRIGGER_ENABLE: IC101.38 (PA15); also elsewhere on the board
T_HOLD: IC101.29 (PC6); also elsewhere on the board
T_JS_PULSE: IC101.27 (PB14), SJ102.2; also elsewhere on the board
T_START: IC101.28 (PB15); also elsewhere on the board
VCP_RX: IC101.32 (PA10); also elsewhere on the board
VCP_TX: IC101.31 (PA9); also elsewhere on the board
VDD: C104.1, C105.1, C106.1, C107.1, D101.C, IC101.1 (VBAT), IC101.20 (VREF+), IC101.21 (VDDA), IC101.23 (VDD), IC101.35 (VDD), IC101.48 (VDD), L101.1, R101.1; also elsewhere on the board

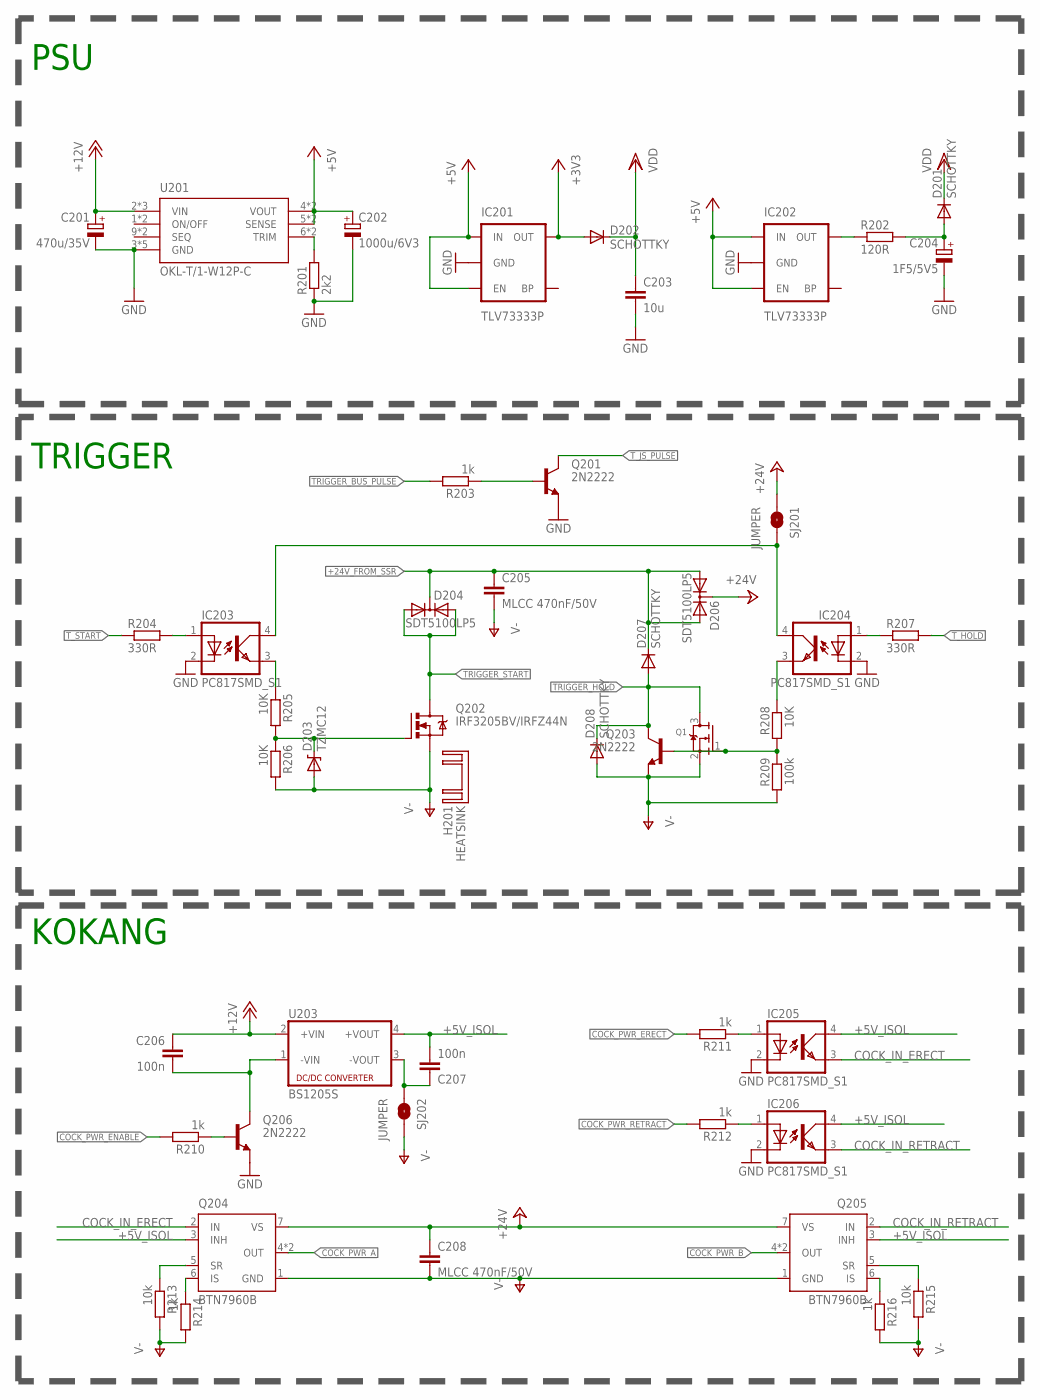
[picture p8: schematic MotorControl.sch, sheet 2]

Parts:
C201: 470u/35V; 153CLV-1012
C202: 1000u/6V3; 153CLV-0810
C203: 10u; C0805
C204: 1F5/5V5; SC_1F/5V5
C205, C208: MLCC 470nF/50V; C150-064X183
C206, C207: 100n; C0603
D201, D202, D207, D208: SCHOTTKY; MICROMELF-W
D203: TZMC12; SMB-DIODE
D204, D206: SDT5100LP5; POWERDI5-3
H201: HEATSINK; BV_240X170-HOLE
IC201, IC202: TLV73333P; SOT23-5
IC203, IC204, IC205, IC206: PC817SMD_S1; PC817SMD
Q1: AO3404-REFLOW; SOT23
Q201, Q203, Q206: 2N2222; SOT23
Q202: IRF3205BV/IRFZ44N; TO220BV
Q204: BTN7960B; PG-TO263-7-1; PARTNO BTN7960B
Q205: BTN7960B; PG-TO263-7-1
R201: 2k2; R0603
R202: 120R; R0603
R203, R210, R211, R212, R214, R216: 1k; R0603
R204, R207: 330R; R0603
R205, R206, R208: 10K; R0603
R209: 100k; R0603
R213, R215: 10k; R0603
SJ201, SJ202: JUMPER; SJ_2S-TRACE_THICK
U201: OKL-T/1-W12P-C; OKL2T/3W5NC
U203: BS1205S; NME

Connections:
+3V3: D202.A, IC201.5 (OUT); also elsewhere on the board
+5V: C202.+, IC201.1 (IN), IC201.3 (EN), IC202.1 (IN), IC202.3 (EN), U201.4 (VOUT), U201.4@1 (VOUT), U201.5 (SENSE), U201.5@1 (SENSE); also elsewhere on the board
+5V_ISOL: C207.2, IC205.4 (COL), IC206.4 (COL), Q204.3 (INH), Q205.3 (INH), U203.4 (+VOUT)
+12V: C201.+, C206.1, U201.2 (VIN), U201.2@1 (VIN), U201.2@2 (VIN), U203.2 (+VIN); also elsewhere on the board
+24V: C208.1, D206.3, Q204.7 (VS), Q205.7 (VS), SJ201.1; also elsewhere on the board
+24V_FROM_SSR: C205.1, D204.3, D206.1, D206.2, D207.C; also elsewhere on the board
COCK_IN_ERECT: IC205.3 (EMIT), Q204.2 (IN)
COCK_IN_RETRACT: IC206.3 (EMIT), Q205.2 (IN)
COCK_PWR_A: Q204.4 (OUT), Q204.8 (OUT); also elsewhere on the board
COCK_PWR_B: Q205.4 (OUT), Q205.8 (OUT); also elsewhere on the board
COCK_PWR_ENABLE: R210.2; also elsewhere on the board
COCK_PWR_ERECT: R211.2; also elsewhere on the board
COCK_PWR_RETRACT: R212.2; also elsewhere on the board
COCK_SENSOR1: Q204.6 (IS), R214.1
GND: C201.-, C202.-, C203.2, C204.2 (-), IC201.2 (GND), IC202.2 (GND), IC203.2 (C), IC204.2 (C), IC205.2 (C), IC206.2 (C), Q201.2 (E), Q206.2 (E), R201.1, U201.3 (GND), U201.3@1 (GND), U201.3@2 (GND), U201.7 (GND), U201.7@1 (GND); also elsewhere on the board
unnamed: IC203.4 (COL), IC204.4 (COL), SJ201.2
unnamed: Q204.5 (SR), R213.1
unnamed: Q205.5 (SR), R215.1
unnamed: Q205.6 (IS), R216.1
unnamed: Q206.1 (B), R210.1
unnamed: C206.2, Q206.3 (C), U203.1 (-VIN)
unnamed: Q201.1 (B), R203.1
unnamed: IC205.1 (A), R211.1
unnamed: R201.2, U201.6 (TRIM), U201.6@1 (TRIM)
unnamed: IC206.1 (A), R212.1
unnamed: C207.1, SJ202.1, U203.3 (-VOUT)
unnamed: D203.C, Q202.G, R205.2, R206.1
unnamed: Q1.1 (G), Q203.1 (B), R208.2, R209.1
unnamed: IC203.3 (EMIT), R205.1
unnamed: IC204.3 (EMIT), R208.1
unnamed: IC204.1 (A), R207.1
unnamed: IC203.1 (A), R204.2
unnamed: IC202.5 (OUT), R202.1
TRIGGER_BUS_PULSE: R203.2; also elsewhere on the board
TRIGGER_HOLD: D207.A, D208.C, Q1.3 (D), Q203.3 (C); also elsewhere on the board
TRIGGER_START: D204.1, D204.2, Q202.D; also elsewhere on the board
T_HOLD: R207.2; also elsewhere on the board
T_JS_PULSE: Q201.3 (C); also elsewhere on the board
T_START: R204.1; also elsewhere on the board
V-: C205.2, C208.2, D203.A, D208.A, Q1.2 (S), Q202.S, Q203.2 (E), Q204.1 (GND), Q205.1 (GND), R206.2, R209.2, R213.2, R214.2, R215.2, R216.2, SJ202.2; also elsewhere on the board
VDD: C203.1, D201.C, D202.C; also elsewhere on the board
V_SCAP: C204.1 (+), D201.A, R202.2

Notes on the sheet:
KOKANG
TRIGGER
PSU

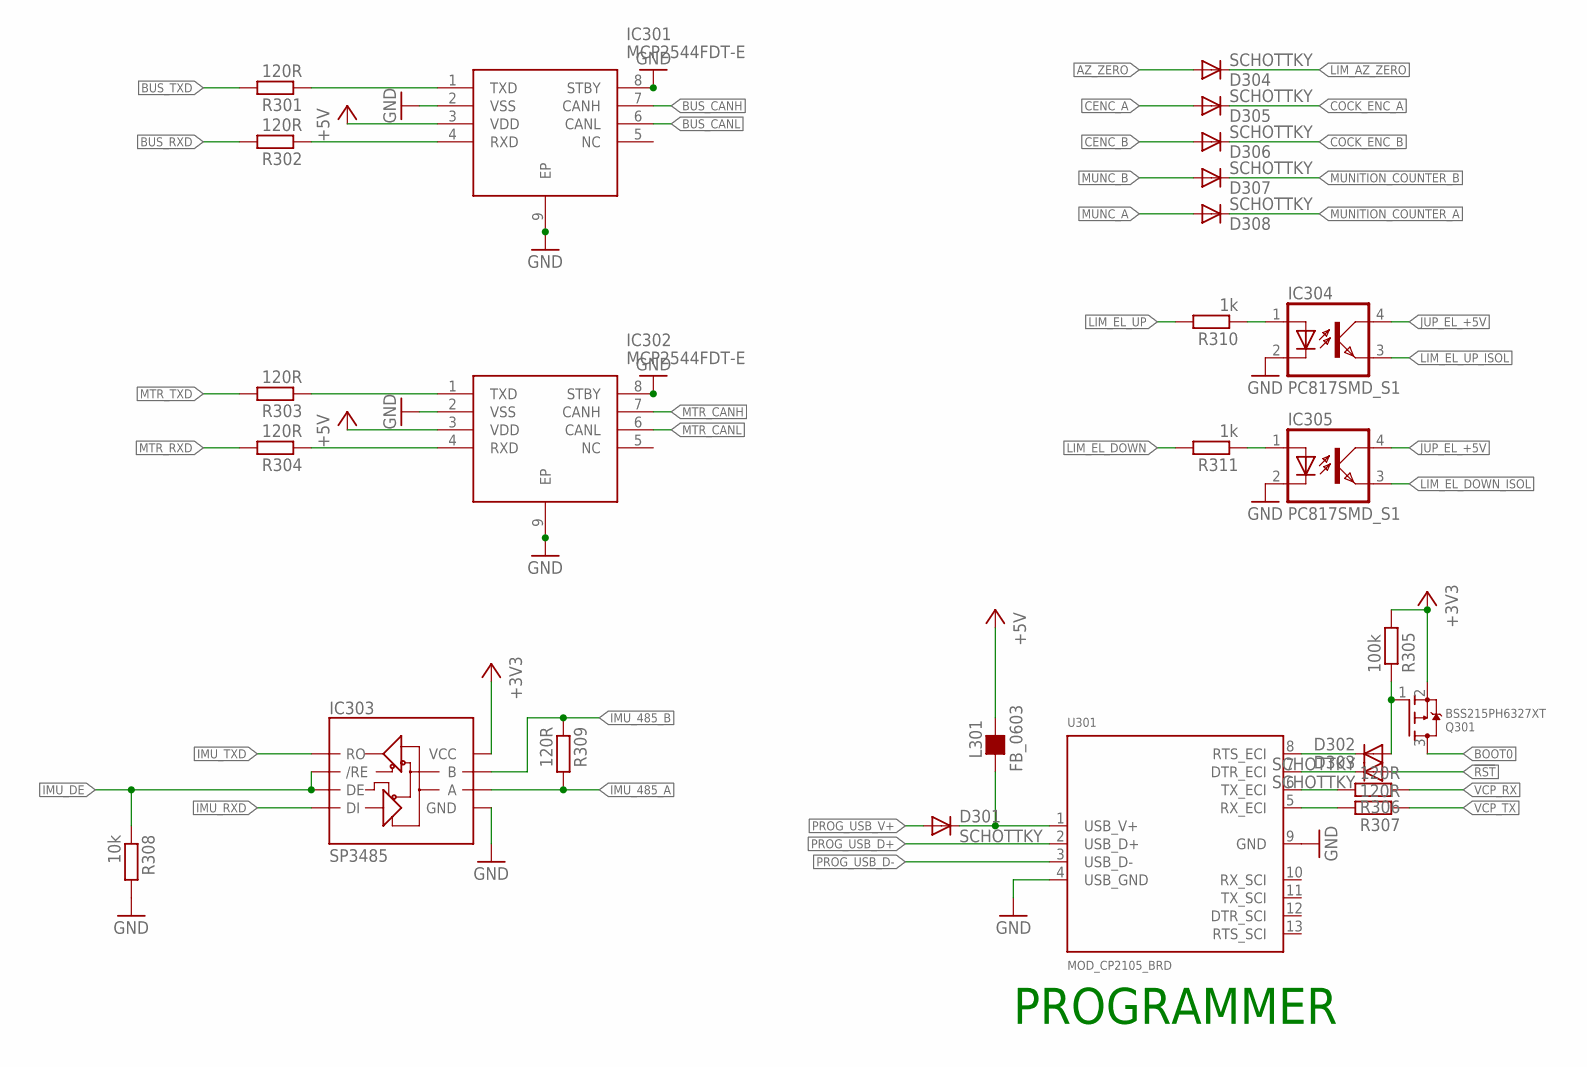
[picture p9: schematic MotorControl.sch, sheet 3]

Parts:
D301, D302, D303, D304, D305, D306, D307, D308: SCHOTTKY; MICROMELF-W
IC301, IC302: MCP2544FDT-E; TDFN-8
IC303: SP3485; SO08
IC304, IC305: PC817SMD_S1; PC817SMD
L301: FB_0603; L0603
Q301: BSS215PH6327XT; SOT23-W
R301, R302, R303, R304, R306, R307, R309: 120R; R0603
R305: 100k; R0603
R308: 10k; R0603
R310, R311: 1k; R0603
U301: MOD_CP2105_BRD; MOD_CP2105_BOARD

Connections:
!RST: D303.A; also elsewhere on the board
+3V3: IC303.8 (VCC), Q301.2 (S), R305.2; also elsewhere on the board
+5V: IC301.3 (VDD), IC302.3 (VDD), L301.2; also elsewhere on the board
AZ_ZERO: D304.A; also elsewhere on the board
BOOT0: Q301.3 (D); also elsewhere on the board
BUS_CANH: IC301.7 (CANH); also elsewhere on the board
BUS_CANL: IC301.6 (CANL); also elsewhere on the board
BUS_RXD: R302.2; also elsewhere on the board
BUS_TXD: R301.2; also elsewhere on the board
CENC_A: D305.A; also elsewhere on the board
CENC_B: D306.A; also elsewhere on the board
COCK_ENC_A: D305.C; also elsewhere on the board
COCK_ENC_B: D306.C; also elsewhere on the board
GND: IC301.2 (VSS), IC301.8 (STBY), IC301.9 (EP), IC302.2 (VSS), IC302.8 (STBY), IC302.9 (EP), IC303.5 (GND), IC304.2 (C), IC305.2 (C), R308.2, U301.4 (USB_GND), U301.9 (GND); also elsewhere on the board
IMU_485_A: IC303.6 (A), R309.2; also elsewhere on the board
IMU_485_B: IC303.7 (B), R309.1; also elsewhere on the board
IMU_DE: IC303.2 (/RE), IC303.3 (DE), R308.1; also elsewhere on the board
IMU_RXD: IC303.4 (DI); also elsewhere on the board
IMU_TXD: IC303.1 (RO); also elsewhere on the board
JUP_EL_+5V: IC304.4 (COL), IC305.4 (COL); also elsewhere on the board
LIM_AZ_ZERO: D304.C; also elsewhere on the board
LIM_EL_DOWN: R311.2; also elsewhere on the board
LIM_EL_DOWN_ISOL: IC305.3 (EMIT); also elsewhere on the board
LIM_EL_UP: R310.2; also elsewhere on the board
LIM_EL_UP_ISOL: IC304.3 (EMIT); also elsewhere on the board
MTR_CANH: IC302.7 (CANH); also elsewhere on the board
MTR_CANL: IC302.6 (CANL); also elsewhere on the board
MTR_RXD: R304.2; also elsewhere on the board
MTR_TXD: R303.2; also elsewhere on the board
MUNC_A: D308.A; also elsewhere on the board
MUNC_B: D307.A; also elsewhere on the board
MUNITION_COUNTER_A: D308.C; also elsewhere on the board
MUNITION_COUNTER_B: D307.C; also elsewhere on the board
unnamed: IC304.1 (A), R310.1
unnamed: R307.2, U301.5 (RX_ECI)
unnamed: R306.2, U301.6 (TX_ECI)
unnamed: D303.C, U301.7 (DTR_ECI)
unnamed: D302.C, U301.8 (RTS_ECI)
unnamed: D301.C, L301.1, U301.1 (USB_V+)
unnamed: D302.A, Q301.1 (G), R305.1
unnamed: IC305.1 (A), R311.1
unnamed: IC301.4 (RXD), R302.1
unnamed: IC301.1 (TXD), R301.1
unnamed: IC302.4 (RXD), R304.1
unnamed: IC302.1 (TXD), R303.1
PROG_USB_D+: U301.2 (USB_D+); also elsewhere on the board
PROG_USB_D-: U301.3 (USB_D-); also elsewhere on the board
PROG_USB_V+: D301.A; also elsewhere on the board
VCP_RX: R306.1; also elsewhere on the board
VCP_TX: R307.1; also elsewhere on the board

Notes on the sheet:
PROGRAMMER

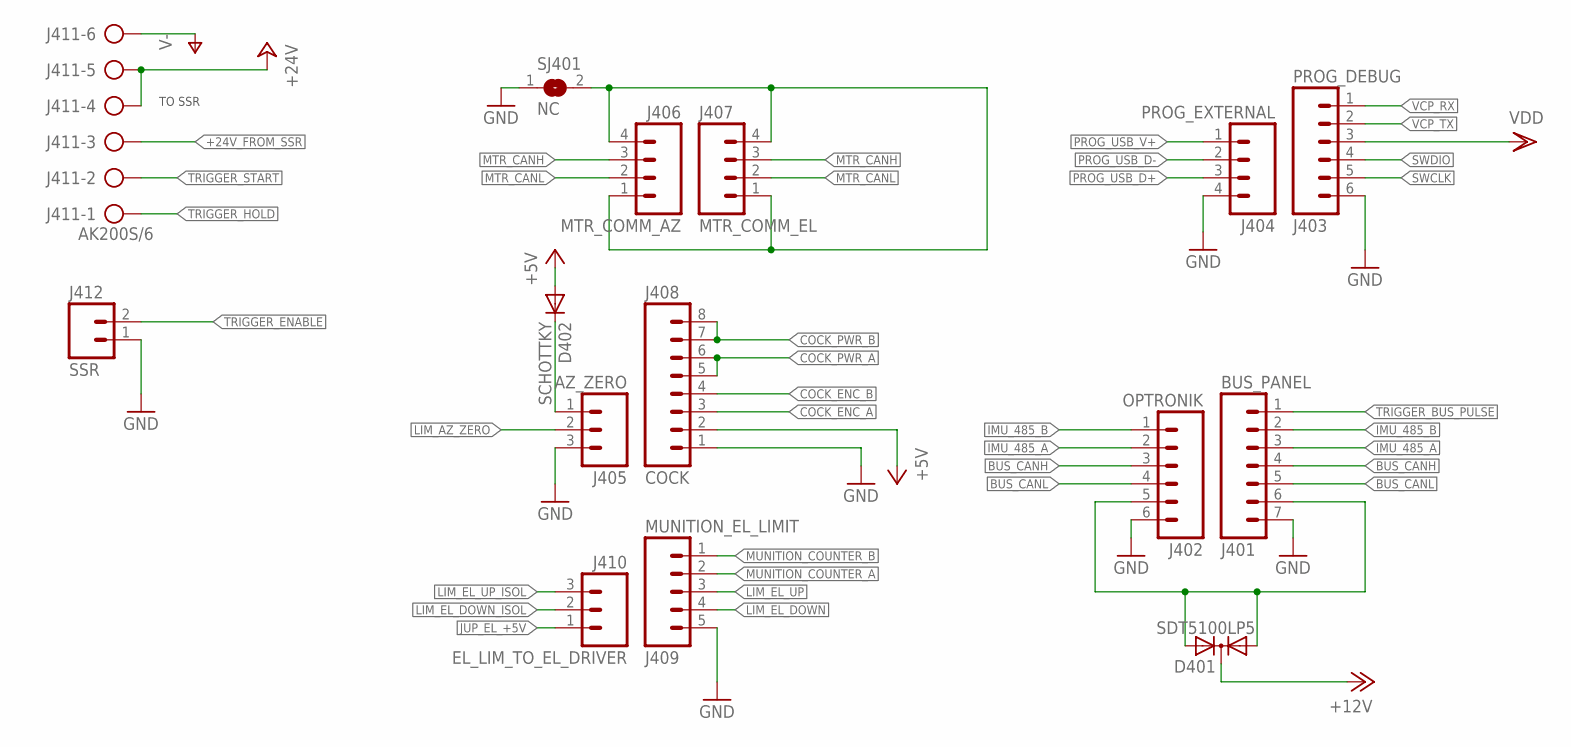
[picture p10: schematic MotorControl.sch, sheet 4]

Parts:
D401: SDT5100LP5; POWERDI5-3
D402: SCHOTTKY; MICROMELF-W
J401: BUS_PANEL; XHS-7-RA
J402: OPTRONIK; XHS-6-RA
J403: PROG_DEBUG; XHS-6-VERT-SMD
J404: PROG_EXTERNAL; XHS-4-RA
J405: AZ_ZERO; XHS-3-RA
J406: MTR_COMM_AZ; MICRO_MATCH_04
J407: MTR_COMM_EL; MICRO_MATCH_04
J408: COCK; XHS-8-RA
J409: MUNITION_EL_LIMIT; XHS-5-RA
J410: EL_LIM_TO_EL_DRIVER; XHS-3-RA
J411: AK200S/6
J412: SSR; XHS-2-RA
SJ401: NC; SJS

Connections:
+5V: D402.A, J408.2; also elsewhere on the board
+12V: D401.3; also elsewhere on the board
+24V: J411.4, J411.5; also elsewhere on the board
+24V_FROM_SSR: J411.3; also elsewhere on the board
BUS_CANH: J401.4, J402.3; also elsewhere on the board
BUS_CANL: J401.5, J402.4; also elsewhere on the board
COCK_ENC_A: J408.3; also elsewhere on the board
COCK_ENC_B: J408.4; also elsewhere on the board
COCK_PWR_A: J408.5, J408.6; also elsewhere on the board
COCK_PWR_B: J408.7, J408.8; also elsewhere on the board
GND: J401.7, J402.6, J403.6, J404.4, J405.3, J408.1, J409.5, J412.1, SJ401.1; also elsewhere on the board
IMU_485_A: J401.3, J402.2; also elsewhere on the board
IMU_485_B: J401.2, J402.1; also elsewhere on the board
JUP_EL_+5V: J410.1; also elsewhere on the board
LIM_AZ_ZERO: J405.2; also elsewhere on the board
LIM_EL_DOWN: J409.4; also elsewhere on the board
LIM_EL_DOWN_ISOL: J410.2; also elsewhere on the board
LIM_EL_UP: J409.3; also elsewhere on the board
LIM_EL_UP_ISOL: J410.3; also elsewhere on the board
MTR_CANH: J406.3, J407.3; also elsewhere on the board
MTR_CANL: J406.2, J407.2; also elsewhere on the board
MUNITION_COUNTER_A: J409.2; also elsewhere on the board
MUNITION_COUNTER_B: J409.1; also elsewhere on the board
unnamed: D402.C, J405.1
unnamed: J406.1, J406.4, J407.1, J407.4, SJ401.2
unnamed: D401.1, D401.2, J401.6, J402.5
PROG_USB_D+: J404.3; also elsewhere on the board
PROG_USB_D-: J404.2; also elsewhere on the board
PROG_USB_V+: J404.1; also elsewhere on the board
SWCLK: J403.5; also elsewhere on the board
SWDIO: J403.4; also elsewhere on the board
TRIGGER_BUS_PULSE: J401.1; also elsewhere on the board
TRIGGER_ENABLE: J412.2; also elsewhere on the board
TRIGGER_HOLD: J411.1; also elsewhere on the board
TRIGGER_START: J411.2; also elsewhere on the board
V-: J411.6; also elsewhere on the board
VCP_RX: J403.1; also elsewhere on the board
VCP_TX: J403.2; also elsewhere on the board
VDD: J403.3; also elsewhere on the board

Notes on the sheet:
TO SSR

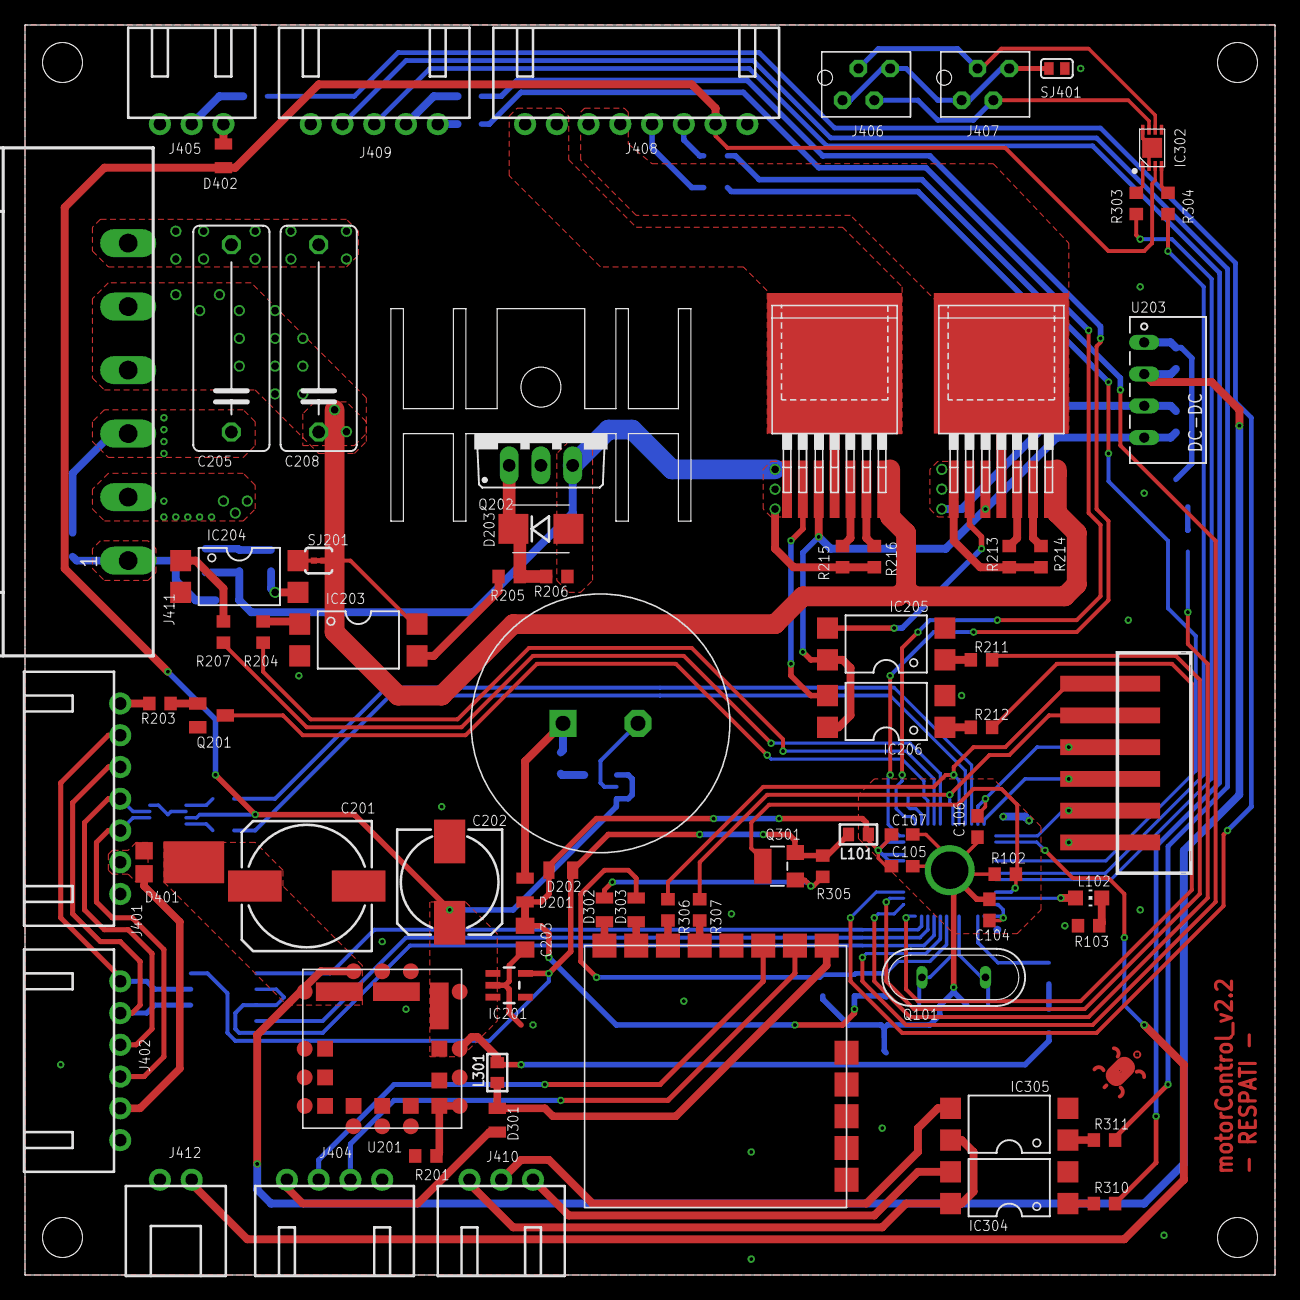
[picture p11: board MotorControl.brd from above]

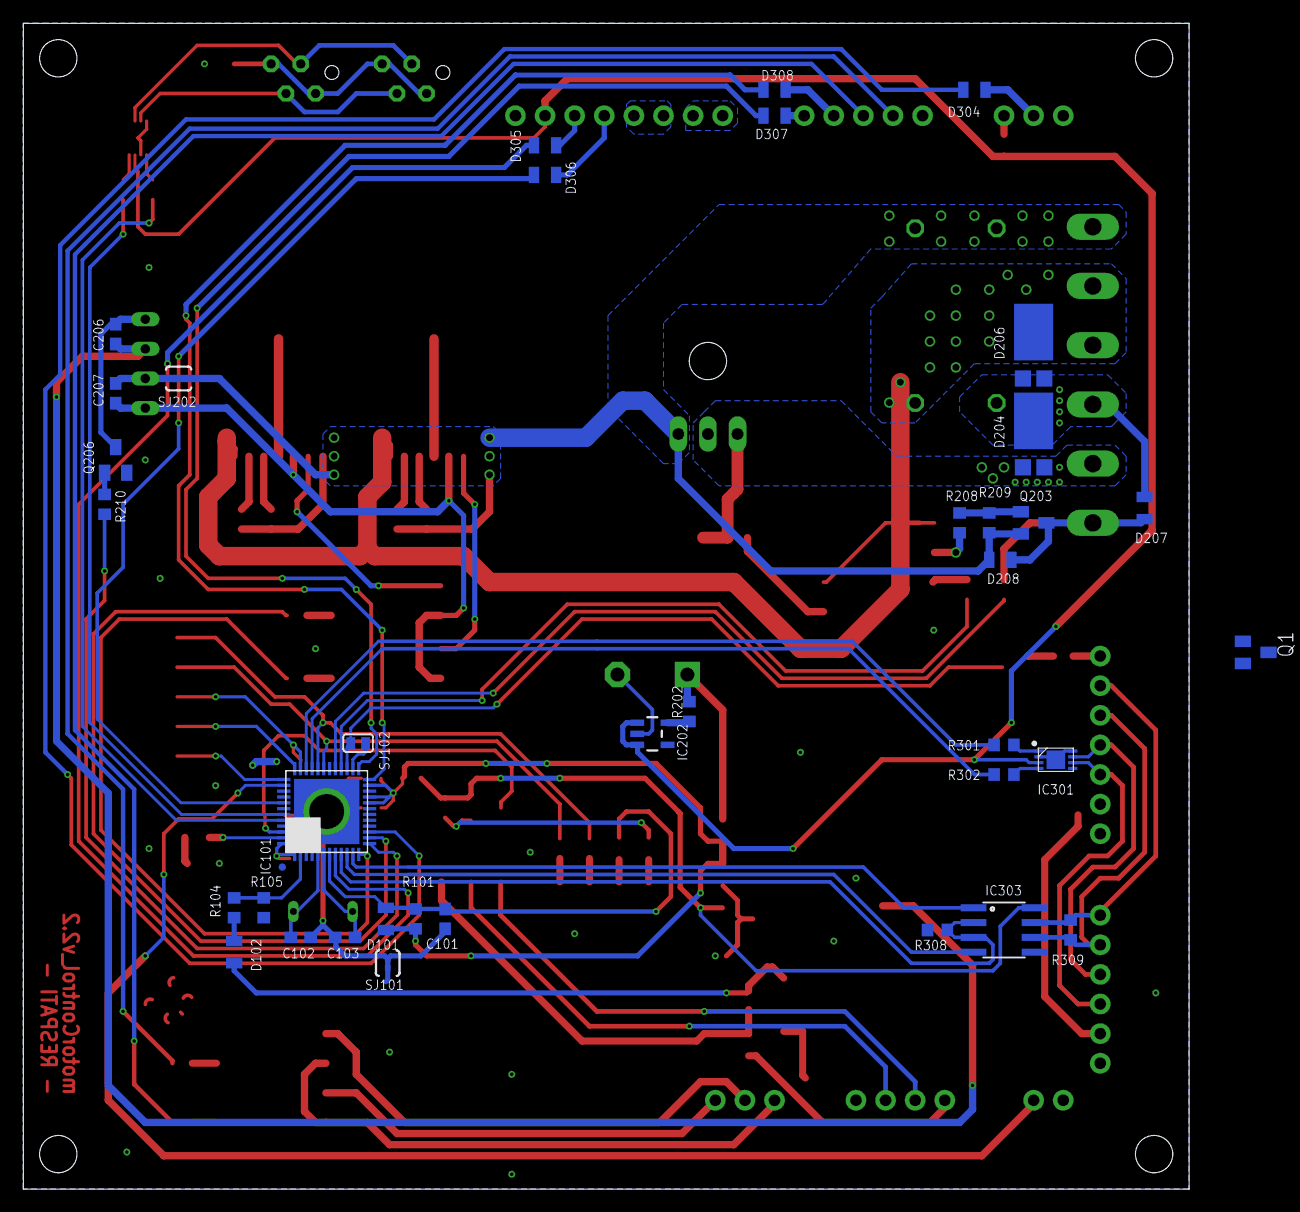
[picture p12: board MotorControl.brd from below]

Board: 2 copper layers, 100.0 x 100.0 mm, 112 parts (38 on the bottom side), 103 nets.
