kurrosetra/RCWS-mk3/Optronik/Board/Optronik(2022).brd

## EAGLE design Optronik/Board/Optronik(2022).brd (2022-07-08)

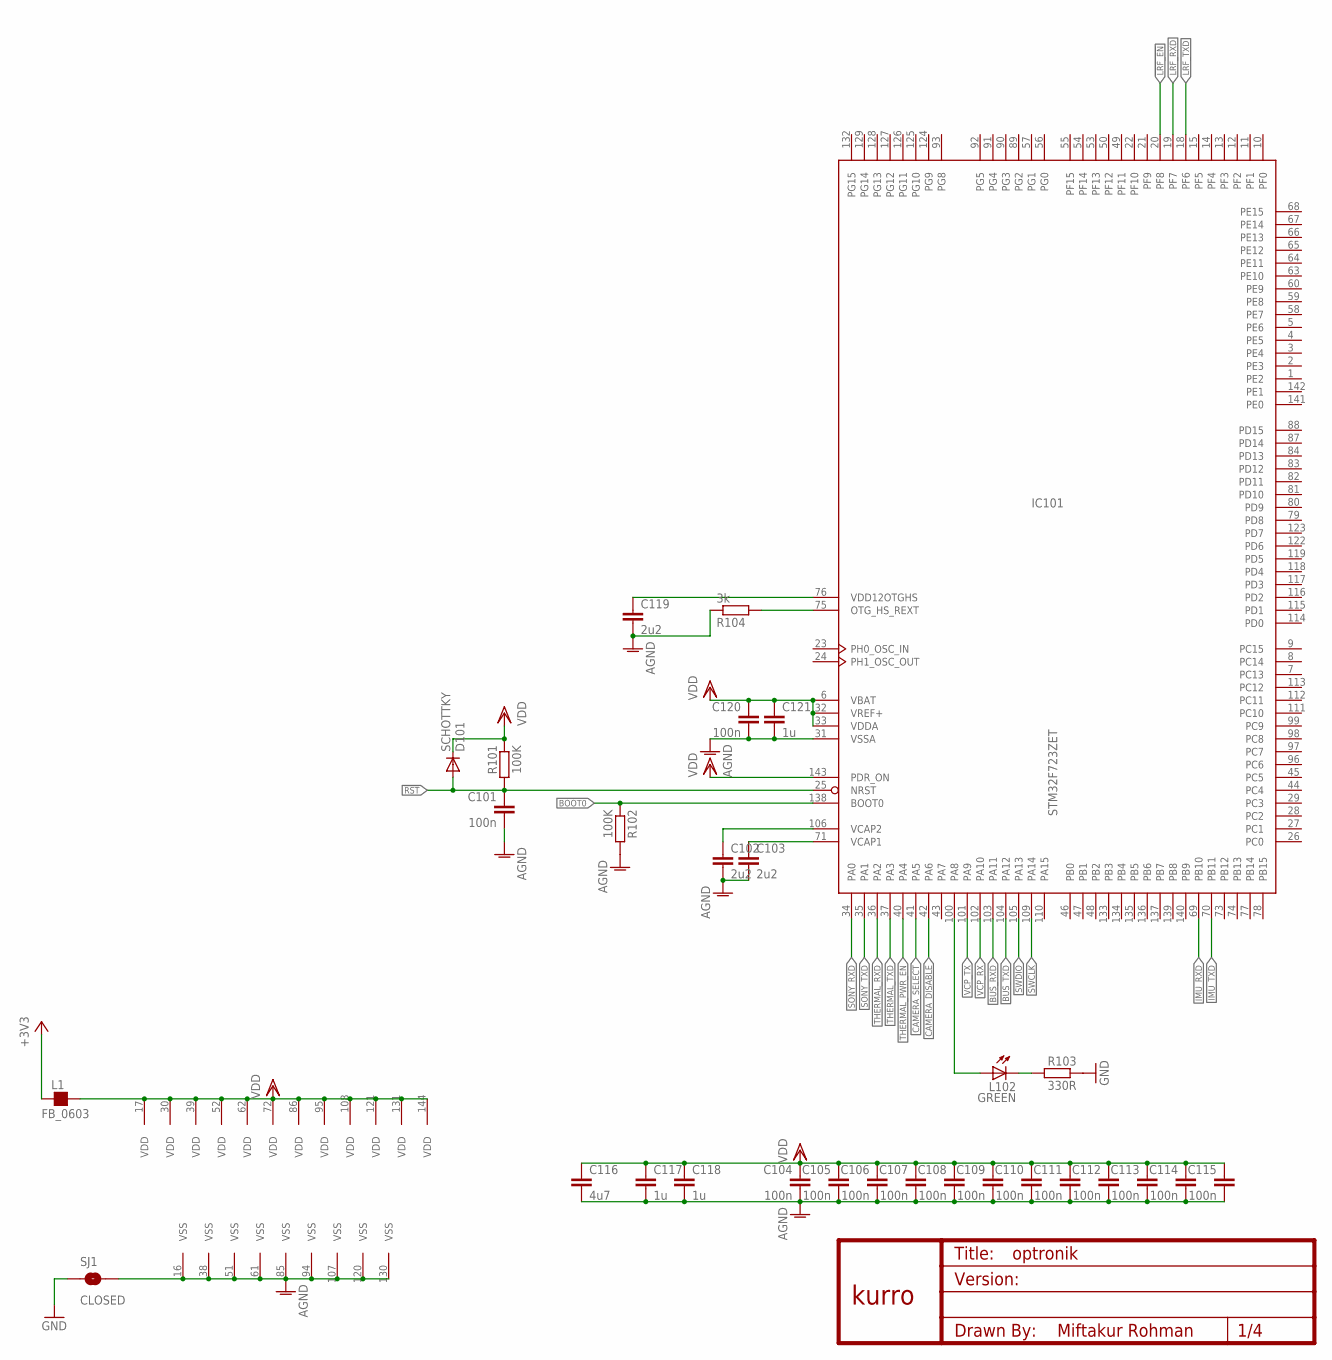
[picture p13: schematic Optronik.sch, sheet 1, MCU_MAIN]

Parts:
C101, C104, C105, C106, C107, C108, C109, C110, C111, C112, C113, C114, C115, C120: 100n; C0603
C102, C103, C119: 2u2; C0805
C116: 4u7; C0805
C117, C118, C121: 1u; C0805
D101: SCHOTTKY; MICROMELF-W
IC101: STM32F723ZET; LQFP144-2
L1: FB_0603; L0603
L102: GREEN; CHIP-LED0805
R101, R102: 100K; R0603
R103: 330R; R0603
R104: 3k; R0603
SJ1: CLOSED; SJ_2S-TRACE_THICK
U$2: KURRO_FOOTPRINT; KURRO-LOGO

Connections:
!LRF_EN: IC101.20 (PF8); also elsewhere on the board
!RST: C101.1, D101.A, IC101.25 (NRST), R101.2; also elsewhere on the board
+3V3: L1.1; also elsewhere on the board
AGND: C101.2, C102.2, C103.2, C104.2, C105.2, C106.2, C107.2, C108.2, C109.2, C110.2, C111.2, C112.2, C113.2, C114.2, C115.2, C116.2, C117.2, C118.2, C119.2, C120.2, C121.2, IC101.16 (VSS), IC101.31 (VSSA), IC101.38 (VSS), IC101.51 (VSS), IC101.61 (VSS), IC101.85 (VSS), IC101.94 (VSS), IC101.107 (VSS), IC101.120 (VSS), IC101.130 (VSS), R102.2, R104.1, SJ1.2
BOOT0: IC101.138 (BOOT0), R102.1; also elsewhere on the board
BUS_RXD: IC101.103 (PA11); also elsewhere on the board
BUS_TXD: IC101.104 (PA12); also elsewhere on the board
CAMERA_DISABLE: IC101.42 (PA6); also elsewhere on the board
CAMERA_SELECT: IC101.41 (PA5); also elsewhere on the board
GND: R103.1, SJ1.1; also elsewhere on the board
IMU_RXD: IC101.69 (PB10); also elsewhere on the board
IMU_TXD: IC101.70 (PB11); also elsewhere on the board
LRF_RXD: IC101.19 (PF7); also elsewhere on the board
LRF_TXD: IC101.18 (PF6); also elsewhere on the board
unnamed: IC101.75 (OTG_HS_REXT), R104.2
unnamed: IC101.100 (PA8), L102.A
unnamed: L102.C, R103.2
unnamed: C119.1, IC101.76 (VDD12OTGHS)
unnamed: C103.1, IC101.71 (VCAP1)
unnamed: C102.1, IC101.106 (VCAP2)
SONY_RXD: IC101.34 (PA0); also elsewhere on the board
SONY_TXD: IC101.35 (PA1); also elsewhere on the board
SWCLK: IC101.109 (PA14); also elsewhere on the board
SWDIO: IC101.105 (PA13); also elsewhere on the board
THERMAL_PWR_EN: IC101.40 (PA4); also elsewhere on the board
THERMAL_RXD: IC101.36 (PA2); also elsewhere on the board
THERMAL_TXD: IC101.37 (PA3); also elsewhere on the board
VCP_RX: IC101.102 (PA10); also elsewhere on the board
VCP_TX: IC101.101 (PA9); also elsewhere on the board
VDD: C104.1, C105.1, C106.1, C107.1, C108.1, C109.1, C110.1, C111.1, C112.1, C113.1, C114.1, C115.1, C116.1, C117.1, C118.1, C120.1, C121.1, D101.C, IC101.6 (VBAT), IC101.17 (VDD), IC101.30 (VDD), IC101.32 (VREF+), IC101.33 (VDDA), IC101.39 (VDD), IC101.52 (VDD), IC101.62 (VDD), IC101.72 (VDD), IC101.86 (VDD), IC101.95 (VDD), IC101.108 (VDD), IC101.121 (VDD), IC101.131 (VDD), IC101.143 (PDR_ON), IC101.144 (VDD), L1.2, R101.1; also elsewhere on the board

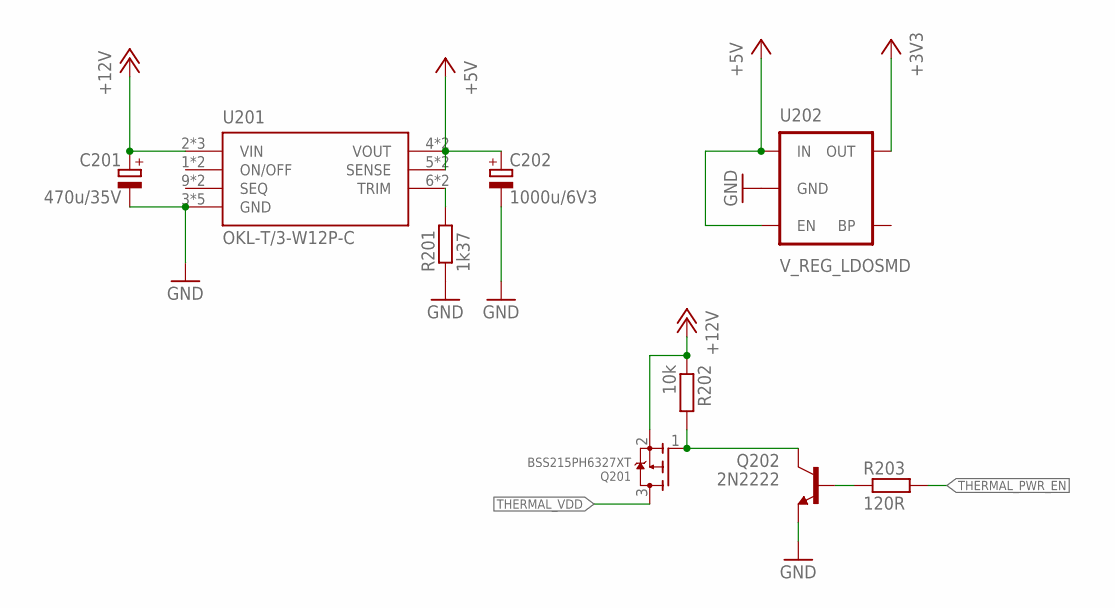
[picture p14: schematic Optronik.sch, sheet 2, PSU]

Parts:
C201: 470u/35V; 153CLV-1012
C202: 1000u/6V3; 153CLV-0810
Q201: BSS215PH6327XT; SOT23-W
Q202: 2N2222; SOT23
R201: 1k37; R0603
R202: 10k; R0603
R203: 120R; R0603
U201: OKL-T/3-W12P-C; OKL2T/3W5NC
U202: V_REG_LDOSMD; SOT23-5

Connections:
+3V3: U202.5 (OUT); also elsewhere on the board
+5V: C202.+, U201.4 (VOUT), U201.4@1 (VOUT), U201.5 (SENSE), U201.5@1 (SENSE), U202.1 (IN), U202.3 (EN); also elsewhere on the board
+12V: C201.+, Q201.2 (S), R202.1, U201.2 (VIN), U201.2@1 (VIN), U201.2@2 (VIN); also elsewhere on the board
GND: C201.-, C202.-, Q202.2 (E), R201.1, U201.3 (GND), U201.3@1 (GND), U201.3@2 (GND), U201.7 (GND), U201.7@1 (GND), U202.2 (GND); also elsewhere on the board
unnamed: R201.2, U201.6 (TRIM), U201.6@1 (TRIM)
unnamed: Q202.1 (B), R203.1
unnamed: Q201.1 (G), Q202.3 (C), R202.2
THERMAL_PWR_EN: R203.2; also elsewhere on the board
THERMAL_VDD: Q201.3 (D); also elsewhere on the board
