kurrosetra/RCWS-mk3/Optronik/Board/Optronik(2022).brd

## EAGLE design Optronik/Board/Optronik(2022).brd (continued)

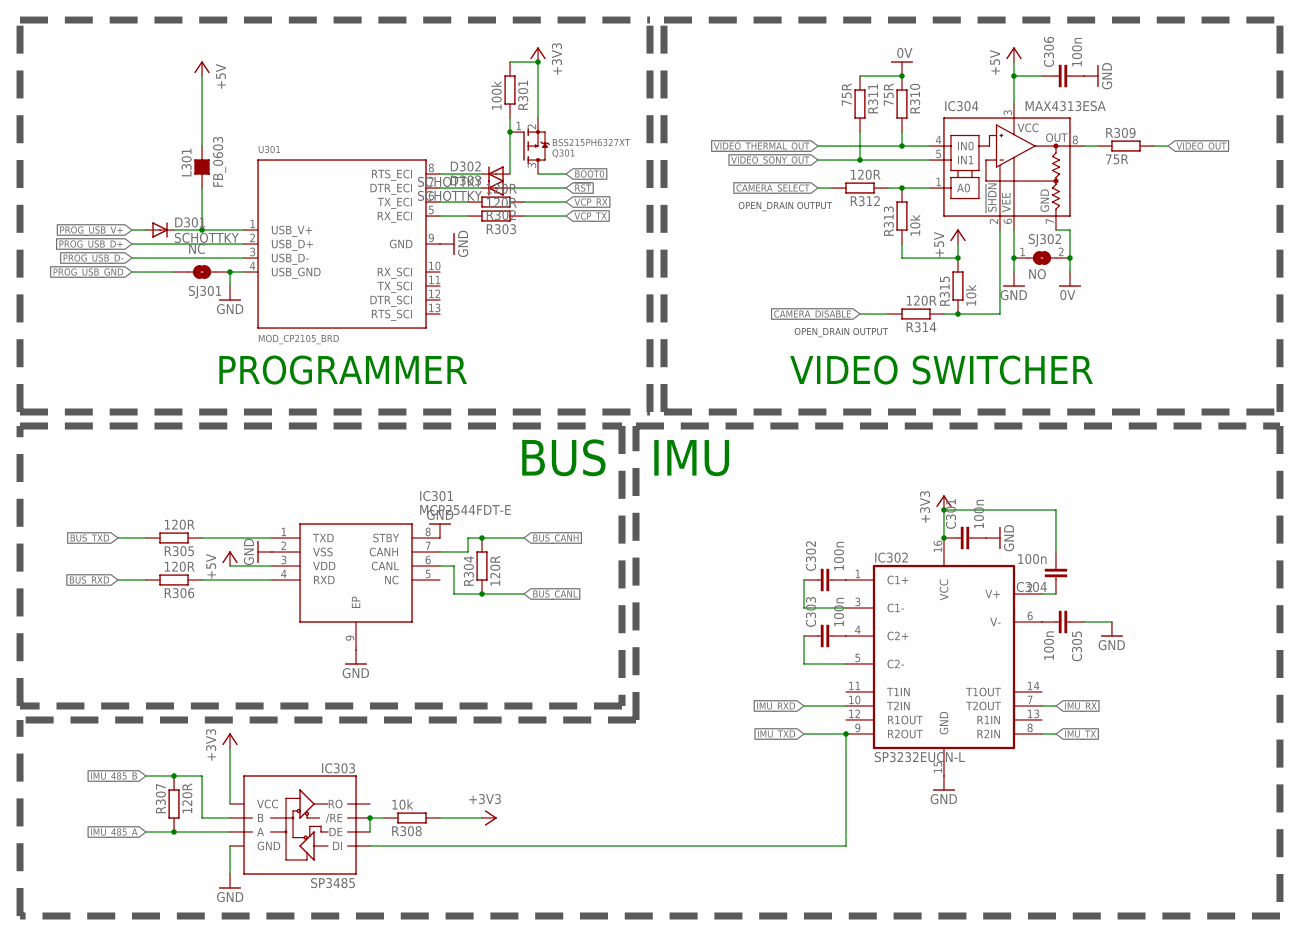
[picture p15: schematic Optronik.sch, sheet 3]

Parts:
C301, C302, C303, C304, C305, C306: 100n; C0603
D301, D302, D303: SCHOTTKY; MICROMELF-W
IC301: MCP2544FDT-E; TDFN-8
IC302: SP3232EUCN-L; SO016
IC303: SP3485; SO08
IC304: MAX4313ESA; SO08
L301: FB_0603; L0603
Q301: BSS215PH6327XT; SOT23-W
R301: 100k; R0603
R302, R303, R304, R305, R306, R307, R312, R314: 120R; R0603
R308, R313, R315: 10k; R0603
R309, R310, R311: 75R; R0603
SJ301: NC; SJ_2S-TRACE_THICK
SJ302: NO; SJS
U301: MOD_CP2105_BRD; MOD_CP2105_BOARD

Connections:
0V: IC304.7 (GND), R310.1, R311.1, SJ302.2; also elsewhere on the board
!RST: D303.A; also elsewhere on the board
+3V3: C301.1, C304.2, IC302.16 (VCC), IC303.8 (VCC), Q301.2 (S), R301.2, R308.2; also elsewhere on the board
+5V: C306.1, IC301.3 (VDD), IC304.3 (V+), L301.2, R313.1, R315.2; also elsewhere on the board
BOOT0: Q301.3 (D); also elsewhere on the board
BUS_CANH: IC301.7 (CANH), R304.2; also elsewhere on the board
BUS_CANL: IC301.6 (CANL), R304.1; also elsewhere on the board
BUS_RXD: R306.2; also elsewhere on the board
BUS_TXD: R305.2; also elsewhere on the board
CAMERA_DISABLE: R314.2; also elsewhere on the board
CAMERA_SELECT: R312.2; also elsewhere on the board
GND: C301.2, C305.1, C306.2, IC301.2 (VSS), IC301.8 (STBY), IC301.9 (EP), IC302.15 (GND), IC303.5 (GND), IC304.6 (V-), SJ301.2, SJ302.1, U301.4 (USB_GND), U301.9 (GND); also elsewhere on the board
IMU_485_A: IC303.6 (A), R307.2; also elsewhere on the board
IMU_485_B: IC303.7 (B), R307.1; also elsewhere on the board
IMU_RX: IC302.7 (T2OUT); also elsewhere on the board
IMU_RXD: IC302.10 (T2IN); also elsewhere on the board
IMU_TX: IC302.8 (R2IN); also elsewhere on the board
IMU_TXD: IC302.9 (R2OUT), IC303.4 (DI); also elsewhere on the board
unnamed: IC303.2 (/RE), IC303.3 (DE), R308.1
unnamed: IC304.1 (A0), R312.1, R313.2
unnamed: IC301.1 (TXD), R305.1
unnamed: IC301.4 (RXD), R306.1
unnamed: R303.2, U301.5 (RX_ECI)
unnamed: R302.2, U301.6 (TX_ECI)
unnamed: D303.C, U301.7 (DTR_ECI)
unnamed: IC304.8 (OUT), R309.1
unnamed: D302.C, U301.8 (RTS_ECI)
unnamed: IC304.2 (!SHDN), R314.1, R315.1
unnamed: D301.C, L301.1, U301.1 (USB_V+)
unnamed: D302.A, Q301.1 (G), R301.1
unnamed: C305.2, IC302.6 (V-)
unnamed: C302.2, IC302.1 (C1+)
unnamed: C303.2, IC302.4 (C2+)
unnamed: C302.1, IC302.3 (C1-)
unnamed: C303.1, IC302.5 (C2-)
unnamed: C304.1, IC302.2 (V+)
PROG_USB_D+: U301.2 (USB_D+); also elsewhere on the board
PROG_USB_D-: U301.3 (USB_D-); also elsewhere on the board
PROG_USB_GND: SJ301.1; also elsewhere on the board
PROG_USB_V+: D301.A; also elsewhere on the board
VCP_RX: R302.1; also elsewhere on the board
VCP_TX: R303.1; also elsewhere on the board
VIDEO_OUT: R309.2; also elsewhere on the board
VIDEO_SONY_OUT: IC304.5 (IN1), R311.2; also elsewhere on the board
VIDEO_THERMAL_OUT: IC304.4 (IN0), R310.2; also elsewhere on the board

Notes on the sheet:
BUS
IMU
OPEN_DRAIN OUTPUT
PROGRAMMER
VIDEO SWITCHER

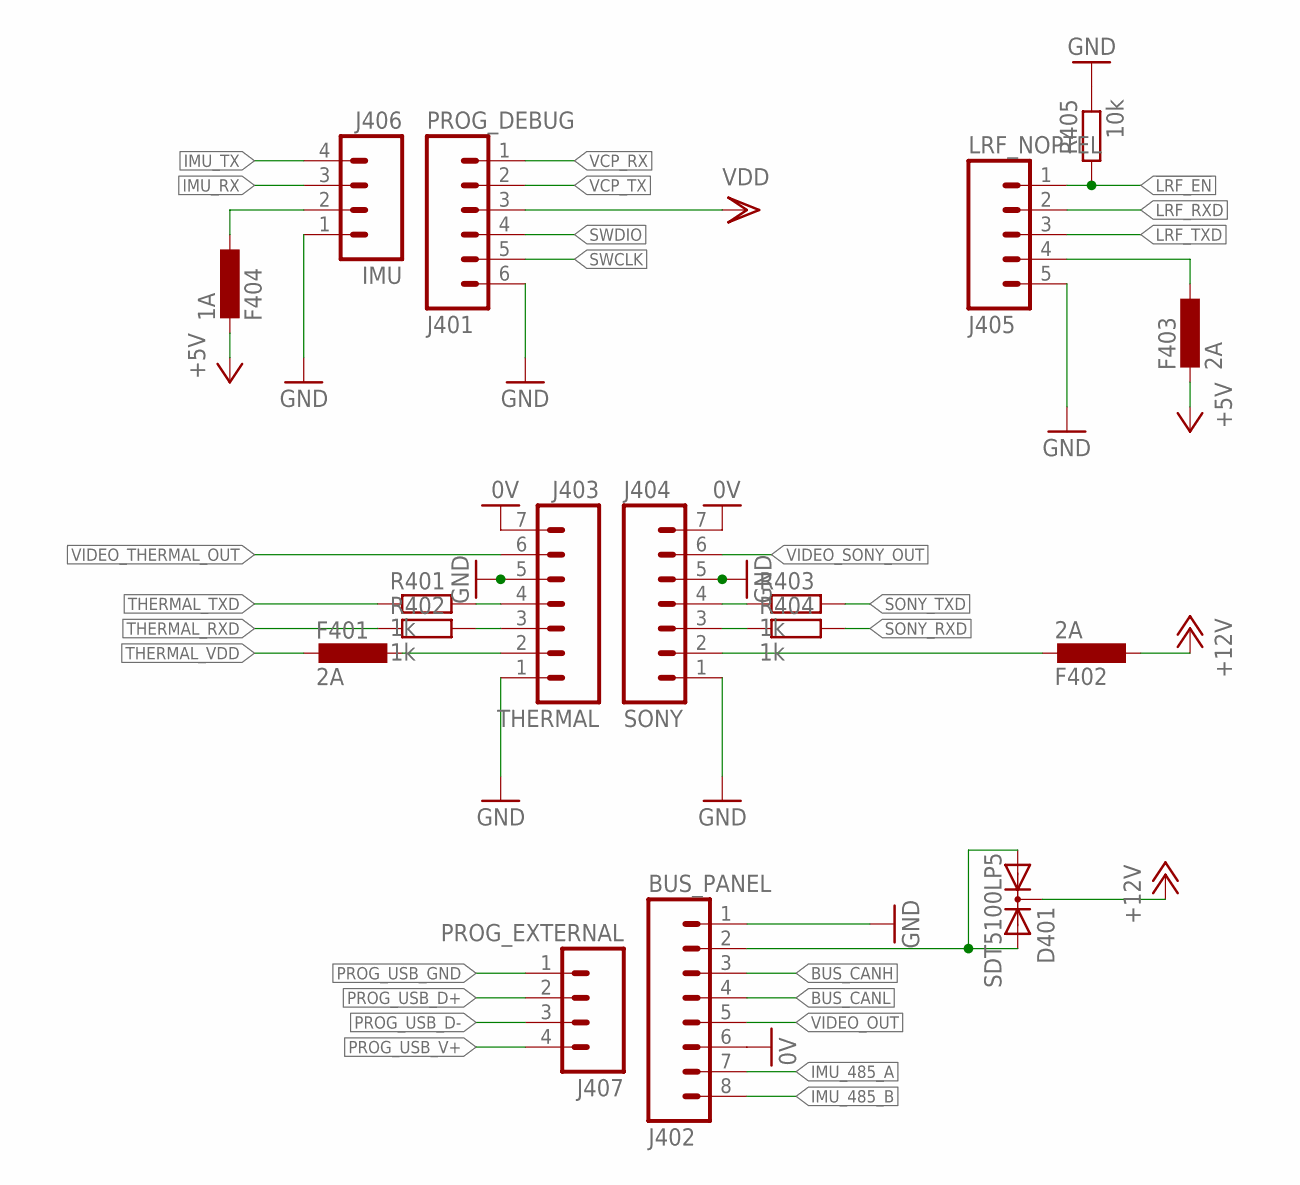
[picture p16: schematic Optronik.sch, sheet 4, CONNECTOR]

Parts:
D401: SDT5100LP5; POWERDI5-3
F401, F402, F403: 2A; L0805
F404: 1A; L0805
J401: PROG_DEBUG; XHS-6-VERT-SMD
J402: BUS_PANEL; XHS-8-RA
J403: THERMAL; XHS-7-RA
J404: SONY; XHS-7-RA
J405: LRF_NOPTEL; XHS-5-RA
J406: IMU; XHS-4-RA
J407: PROG_EXTERNAL; XHS-4-RA
R401, R402, R403, R404: 1k; R0603
R405: 10k; R0603

Connections:
0V: J402.6, J403.7, J404.7; also elsewhere on the board
!LRF_EN: J405.1, R405.2; also elsewhere on the board
+5V: F403.2, F404.2; also elsewhere on the board
+12V: D401.3, F402.1; also elsewhere on the board
BUS_CANH: J402.3; also elsewhere on the board
BUS_CANL: J402.4; also elsewhere on the board
GND: J401.6, J402.1, J403.1, J403.5, J404.1, J404.5, J405.5, J406.1, R405.1; also elsewhere on the board
IMU_485_A: J402.7; also elsewhere on the board
IMU_485_B: J402.8; also elsewhere on the board
IMU_RX: J406.3; also elsewhere on the board
IMU_TX: J406.4; also elsewhere on the board
LRF_RXD: J405.2; also elsewhere on the board
LRF_TXD: J405.3; also elsewhere on the board
unnamed: F403.1, J405.4
unnamed: F402.2, J404.2
unnamed: J403.4, R401.2
unnamed: F401.1, J403.2
unnamed: J403.3, R402.2
unnamed: J404.4, R403.1
unnamed: J404.3, R404.1
unnamed: F404.1, J406.2
PROG_USB_D+: J407.2; also elsewhere on the board
PROG_USB_D-: J407.3; also elsewhere on the board
PROG_USB_GND: J407.1; also elsewhere on the board
PROG_USB_V+: J407.4; also elsewhere on the board
RAW_12V: D401.1, D401.2, J402.2
SONY_RXD: R404.2; also elsewhere on the board
SONY_TXD: R403.2; also elsewhere on the board
SWCLK: J401.5; also elsewhere on the board
SWDIO: J401.4; also elsewhere on the board
THERMAL_RXD: R402.1; also elsewhere on the board
THERMAL_TXD: R401.1; also elsewhere on the board
THERMAL_VDD: F401.2; also elsewhere on the board
VCP_RX: J401.1; also elsewhere on the board
VCP_TX: J401.2; also elsewhere on the board
VDD: J401.3; also elsewhere on the board
VIDEO_OUT: J402.5; also elsewhere on the board
VIDEO_SONY_OUT: J404.6; also elsewhere on the board
VIDEO_THERMAL_OUT: J403.6; also elsewhere on the board

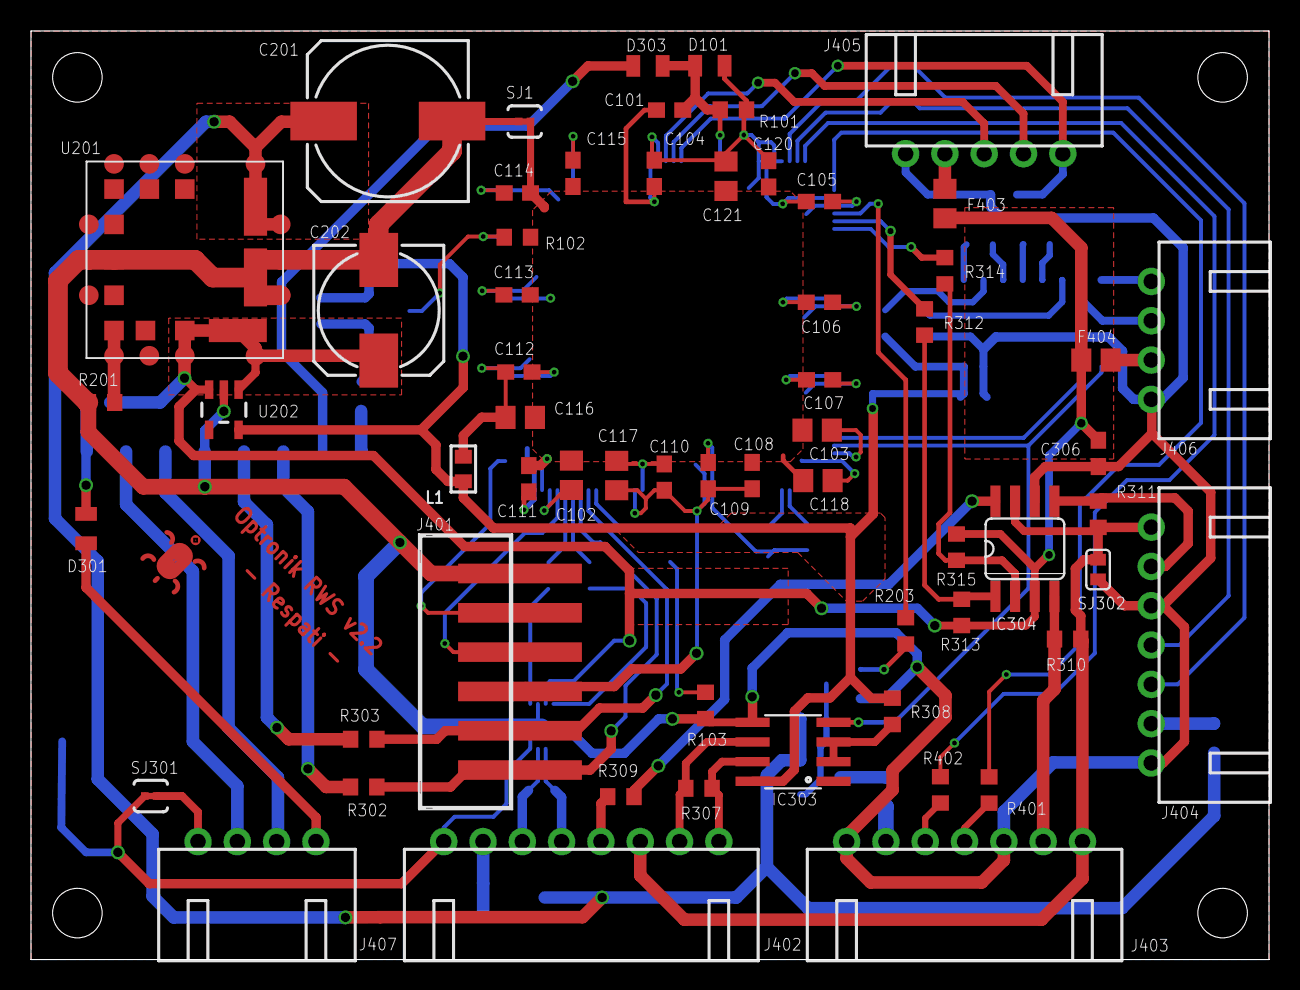
[picture p17: board Optronik(2022).brd from above]

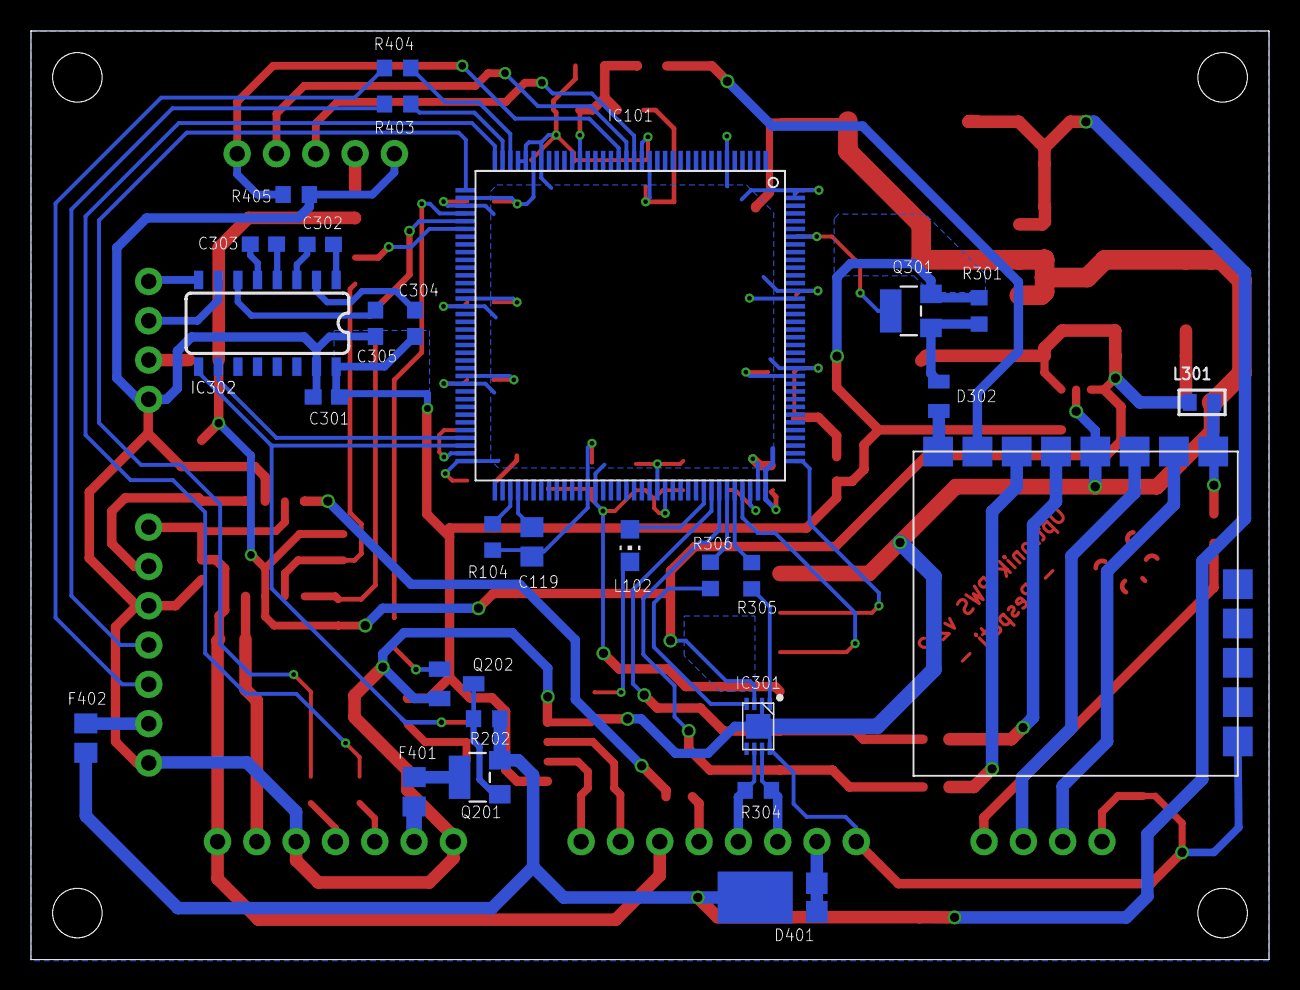
[picture p18: board Optronik(2022).brd from below]

Board: 2 copper layers, 80.0 x 60.0 mm, 90 parts (29 on the bottom side), 77 nets.
