kurrosetra/RCWS-mk3/MotorController/Firmware/MotorController_v2.2/MotorController_v2.2.ioc

Mcu.UserName=STM32G491CEUx
PA0.GPIO_Label=COCK_ENC_A
PA0.Signal=S_TIM2_CH1
PA1.GPIO_Label=IMU_DE
PA1.Signal=USART2_DE
PA10.GPIO_Label=VCP_RX
PA10.Signal=USART1_RX
PA11.GPIO_Label=BUS_RX
PA11.Signal=FDCAN1_RX
PA12.GPIO_Label=BUS_TX
PA12.Signal=FDCAN1_TX
PA13.Signal=SYS_JTMS-SWDIO
PA14.Signal=SYS_JTCK-SWCLK
PA15.GPIO_Label=TRIGGER_ENABLE
PA15.Signal=GPIO_Output
PA2.GPIO_Label=IMU_RX
PA2.Signal=USART2_TX
PA3.GPIO_Label=IMU_TX
PA3.Signal=USART2_RX
PA4.GPIO_Label=COCK_PWR_RETRACT
PA4.Signal=S_TIM3_CH2
PA5.GPIO_Label=COCK_PWR_EN
PA5.Signal=GPIO_Output
PA6.GPIO_Label=COCK_PWR_ERECT
PA6.Signal=S_TIM3_CH1
PA7.GPIO_Label=LIM_AZ_ZERO
PA7.Signal=GPXTI7
PA9.GPIO_Label=VCP_TX
PA9.Signal=USART1_TX
PB11.GPIO_Label=MUNC_A
PB11.Signal=GPXTI11
PB12.GPIO_Label=MUNC_B
PB12.Signal=GPXTI12
PB14.GPIO_Label=T_JS_PULSE
PB14.Signal=GPIO_Input
PB15.GPIO_Label=T_START
PB15.Signal=GPIO_Output
PB3.GPIO_Label=COCK_ENC_B
PB3.Signal=S_TIM2_CH2
PB5.GPIO_Label=MOTOR_RX
PB5.Signal=FDCAN2_RX
PB6.GPIO_Label=MOTOR_TX
PB6.Signal=FDCAN2_TX
PB8-BOOT0.GPIO_Label=BOOT0
PB8-BOOT0.Signal=GPIO_Input
PB9.GPIO_Label=LED_BUILTIN
PB9.Signal=GPIO_Output
PC13.Signal=SYS_WKUP2
PC6.GPIO_Label=T_HOLD
PC6.Signal=GPIO_Output
PF0-OSC_IN.Signal=RCC_OSC_IN
PF1-OSC_OUT.Signal=RCC_OSC_OUT
PG10-NRST.GPIO_Label=NRST
PG10-NRST.Signal=GPIO_Input
