kurrosetra/RCWS-mk3/MotorController/Firmware/RCWS/driver/ingenia/ingenia_buffer.c

/*
 * ingenia_buffer.c
 *
 *  Created on: Jan 5, 2022
 *      Author: miftakur
 */

#include "ingenia_buffer.h"

#include <string.h>

uint8_t can_buffer_available(CAN_Buffer_t *buffer)
{
	if (buffer->head != buffer->tail)
		return (buffer->head >= buffer->tail) ?
				(buffer->head - buffer->tail) : (buffer->head + CAN_RX_BUFFER_SIZE - buffer->tail);

	return 0;
}

void can_buffer_write(CAN_Buffer_t *buffer, CAN_Data_t *data)
{
	uint8_t head = (buffer->head + 1) % CAN_RX_BUFFER_SIZE;

	if (head != buffer->tail) {
		buffer->buf[buffer->head].id = data->id;
		buffer->buf[buffer->head].len = data->len;
		memset(buffer->buf[buffer->head].rxData, 0, CAN_DATA_MAX);
		memcpy(buffer->buf[buffer->head].rxData, data->rxData, CAN_DATA_MAX);

		buffer->head = head;
	}
}

int8_t can_buffer_peek(CAN_Buffer_t *buffer, CAN_Data_t *data)
{
	if (buffer->head != buffer->tail) {
		*data = buffer->buf[buffer->tail];

		return can_buffer_available(buffer);
	}

	return -1;
}

int8_t can_buffer_read(CAN_Buffer_t *buffer, CAN_Data_t *data)
{
	int8_t ret = can_buffer_peek(buffer, data);
	if (ret > 0)
		buffer->tail = (buffer->tail + 1) % CAN_RX_BUFFER_SIZE;

	return ret;
}

void can_buffer_flush(CAN_Buffer_t *buffer)
{
	buffer->head = buffer->tail = 0;
}
