kurrosetra/RCWS-mk3/Optronik/Firmware/F723ZET_Optronik_RTOS/RCWS/driver/noptel/noptel_conf.h

/*
 * noptel_conf.h
 *
 *  Created on: Jan 1, 2022
 *      Author: miftakur
 */

#ifndef DRIVER_NOPTEL_NOPTEL_CONF_H_
#define DRIVER_NOPTEL_NOPTEL_CONF_H_

#define DEBUG_NOPTEL						1

#endif /* DRIVER_NOPTEL_NOPTEL_CONF_H_ */
