kurrosetra/RCWS-mk3/Optronik/Firmware/F723ZET_Optronik_RTOS/RCWS/driver/tbt/tbt_conf.h

/*
 * tbt_conf.h
 *
 *  Created on: Dec 30, 2021
 *      Author: miftakur
 */

#ifndef DRIVER_TBT_TBT_CONF_H_
#define DRIVER_TBT_TBT_CONF_H_

#define DEBUG_TBT						1


#endif /* DRIVER_TBT_TBT_CONF_H_ */
