kurrosetra/RCWS-mk3/(commit log)

2021-12-01 misc update
    [fdcan_ID.xlsx]
2022-07-08 beta release 0.1.1
    - optronik perlu di tuning lagi rtos nya
    - motor control juga
    - panel musti di rtos kan
    [Konektor Lists v.1.2a.xlsx, Konektor Lists v.1.3.xlsx, Konektor Lists v.1.4.xlsx, MotorControl.brd, MotorControl.sch, Optronik(2022).brd, Optronik.sch, Panel.brd]
2022-07-15 tuning rtos motorControl
    [canID.xlsx]
2022-07-15 cleaning again
    Preparing the Cleanup:
    -------------------------
    Before cleaning up your repository, you should conduct two important preparations:
    1. Make sure your .gitignore file is up-to-date and contains all the correct patterns you want to ignore.
    2. Commit or stash any outstanding local changes you might have. Your working copy should be clean before you continue.
    Cleaning Ignored Files:
    -------------------------
    In three steps, you can clean up your repository and make sure your ignored items are indeed ignored:
    # Remove the files from the index (not the actual files in the working copy)
    $ git rm -r --cached .
    # Add these removals to the Staging Area...
    $ git add .
    # ...and commit th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
    [canID.xlsx]
2022-07-20 major: add munition counter
    also update motorController
    [sonyConnector_.brd, sonyConnector_.sch]
