kurrosetra/RCWS-mk3/(notices)

Notices in the files:
Panel/Firmware/F723ZET_Panel/Core/Src/usart.c:
Copyright (c) 2022 STMicroelectronics.
All rights reserved.
This software is licensed under terms that can be found in the LICENSE file
parts and their libraries:
SparkFun: Licensing: CC v3.0 Share-Alike You are welcome to use this library for commercial purposes.
rc-master: Copyright (C) 2007, Bob Starr
